hansfilipelo/Kandidadprojekt/Skrivuppgifter/Reglering/kom.tex

%Laborationsrapport

\documentclass[a4paper,12pt,fleqn]{article}
\usepackage{fixltx2e}
\usepackage[utf8]{inputenc}
\usepackage{graphicx}
\usepackage{sidecap}
\usepackage{fancyhdr}
\usepackage{amssymb,amsmath}
\usepackage[swedish]{babel}
\usepackage[margin=1.5in]{geometry}
\usepackage{abstract}
\usepackage[parfill]{parskip}
\usepackage{tocloft}
\usepackage{adjustbox}
\usepackage{textcomp}
\usepackage[T1]{fontenc}
\usepackage{listings}
\usepackage{xcolor,colortbl}
\usepackage{hyperref}

\include{pagestyle}

%-------------------------------------------------------------------
%Första sidan

\begin{document}
	\pagestyle{fancy}
\pagenumbering{roman}
	\vspace*{\fill}
		\begingroup
			\begin{center}
				\huge{\textbf{Trådlös kommunikation}}
				\\
				\vspace{10pt}
				\normalsize
				Niklas Ericson och Jens Edhammer
				\\
				Kandidatprojekt Y - Grupp 8 - VT2014
				\\
				Version 1.0
				\end{center}
		\endgroup
	\vspace*{\fill}
	
	\begin{center} %Börjar centrering 
		Status
		\\
		\vspace{3pt} %Whitespace 3 pts
	    \begin{tabular}{| p{3cm} | p{3cm} | p{3cm} |} %tabell, 4 horizontella |, 3 cm emellan dem.
	    \hline %översta horizontella linjen.
	    Granskad & - & \today \\ \hline % & -tecken för att "gå till nästa ruta" 
		Godkänd & - & - \\ \hline % avslutas med \\ och \hline.

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

				\end{center}
		\endgroup
	\vspace*{\fill}
\newpage

%-----------------------------------------------------------------
%Innehållsföreteckning

\addto\captionsswedish{\renewcommand{\contentsname}{Innehållsförteckning}}

\tableofcontents
\thispagestyle{fancy}
\newpage

\pagenumbering{arabic}
%-----------------------------------------------------------------
%Översikt
\section{Inledning}

Disposition: 
\\
1. Inledning 
\\
2. Problemformulering (frågeställningar som rapporten ska behandla) 
\\
3. Kunskapsbas (litteratur, datablad, dokumentation, etc.) 
\\
4. Fördjupningstext (modeller, beräkningar, analyser och eventuella experiment) 
\\
5. Resultat och slutsatser 

% ----------------------------- Appendix -----------------------------------------

\newpage
\appendix
\pagestyle{empty}
\newgeometry{left=2cm,right=2cm,bottom=2cm,top=2cm}
\section{Appendix A}

\end{document}
