hansfilipelo/Kandidadprojekt/Jensanteckningar.rtf

Modulär hårdvara

Samtliga kort är lätta att ta bort. Kräver inte ens verktyg.
En bandkabel mellan korten kopplar samman.
Bandkabel mellan vagn och styrmodulen.
Alla sensorer sitter på stiftlister eller i socklar.
Sensorerna är så länge samma model, plug and play.
Detsamma gäller för Bluetoothen. Ett standard konfigurerat
Firefly Bluesmirf modem kommer att fungera out of the box.
Bara att koppla in, i den färdiga sockeln på kommunikationskortet.

Nu vill vi prata lite mer om de individuella modulerna.

1:20

Kommunikationsmodul
Sköter kommunikationen och är navet i roboten.
SPI-Buss.
Vår SPI buss utnyttjar en dubbelbuffer (mottagning, datahantering).
Hantering sker utanför avbrotten med hjälp av bool på master.
Nytt avbrott genereras på slaves när data ska hanteras.
Vi har avbrott uppåt från dottermodulerna.
Vi har ett eget protokoll som börjar med att ge en längd. Väldigt modulärt protokoll.

Bluetooth
Bluetooth använder samma protokoll men har fix längd på 27 (max längd över SPI).
Detta förenklar mottagningsfunktionerna på PC och AVR sidan.

LCD-display
Buffersystem, läser readyflagga en gång per main-loop, uppdaterar position alt. tecken.

Lärdomar
Vi har lärt oss väldigt mycket.
Saker vi vill göra annorlunda eller arbeta vidare med i nästa projekt.

Svårt att implementera buss.
Många skulle nog hålla med oss.
Utnyttja en länkad lista på alla processorer en för skickning en för mottagning.
Gå ut och med jämna mellanrum och fråga modulerna efter data istället
(skulle försämra våra svängar pga ’latens’.)
Ändra strukturen och uppgifterna hos modulerna för att minimera (kritisk) kommunikation.
Paritet eller Ack-struktur.

Starkare huvudprocessor för klasstruktur och beslut med dotterprocessorer för utförande.
En stark ARM huvudprocessor för tillgång till fulla standardbiblioteket i C++.
Låt Huvudprocessorn göra alla beslut och be dottermodulerna utföra dessa istället.

Oscilloskopets styrka i felsökning.
