hansfilipelo/Kandidadprojekt/Presentation/Presentation.pdf

# MapMaster2001

Den kartritande roboten

Nikki

Nikki 2 min

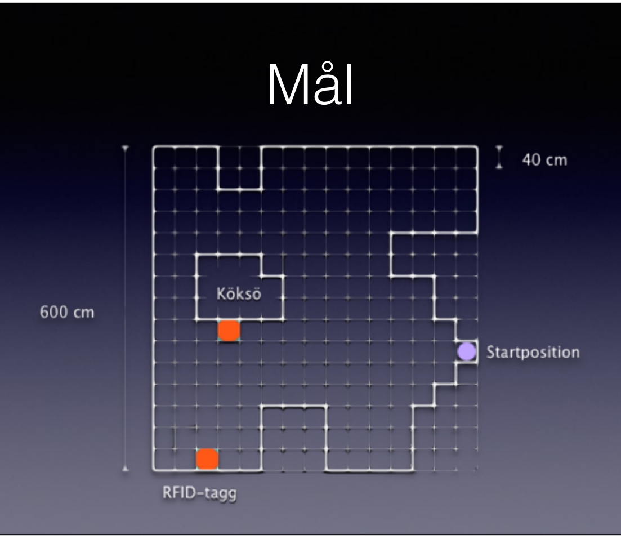
[picture p44: figure]
Mål

Nikki - 30-45 sekunder

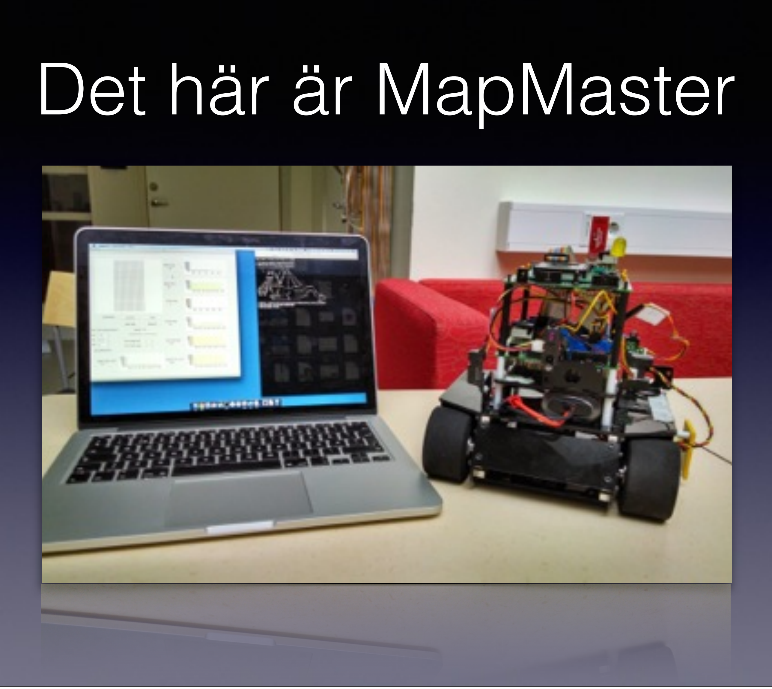
[picture p45: figure]
Det här är MapMaster

# Funktion

- Avsöker och kartlägger ett område
- Ritar karta i ett modernt användargränssnitt
- Bygger på en objektorienterad design
- Spara data och granska den i efterhand

Nikki - 2 min

# Användargränssnitt

Tobias - 1 min

Tobias - 2 min

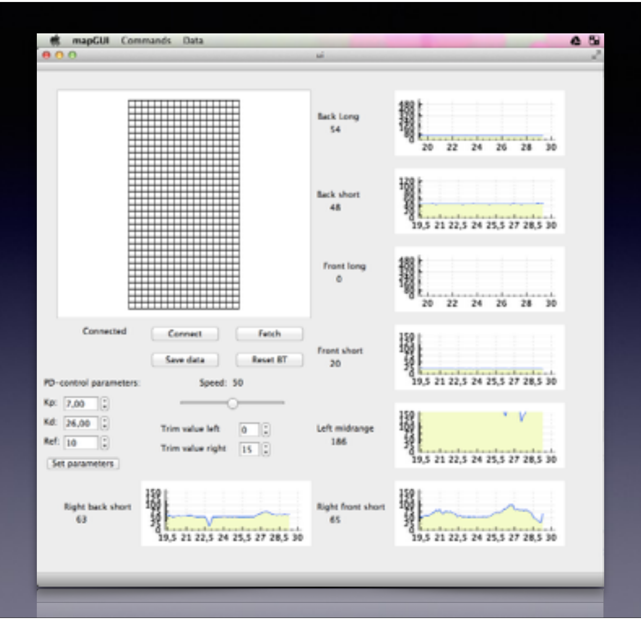
[picture p46: figure]

# Kartabstraktion

H-F - 2 min

# Objektorienterad karta

- Kan fråga kartobjekt
- Mer intelligens med mindre arbete

H-F

# Canceralgoritmen

H-F - 2 min

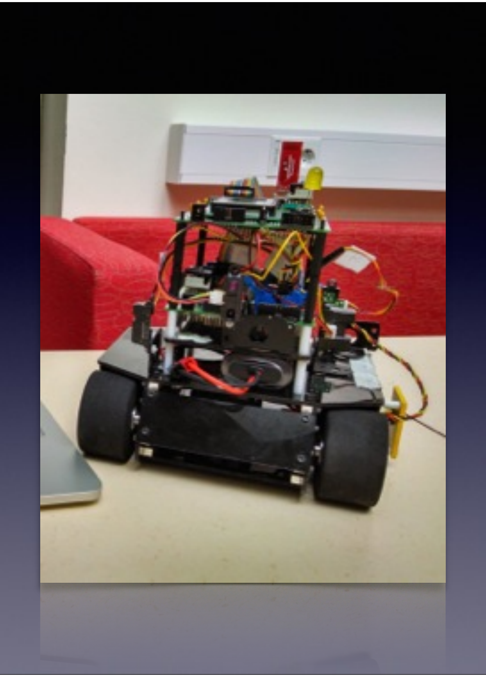
[picture p47: figure]

## Modulär hårdvara

Jens - 1,5 min

# Kommunikationsmodul

- SPI-buss
- Bluetooth
- LCD-display

Jens - 4 min

# Sensormodul

- Lågpassfiltrering av sensorer
- Medelvärdesbildning av sensordata
- Självkalibrerande gyro

David - 3 min

# Styrmodul

- Dubbel proportionell reglering med deriverande effekt.
- Kartläggningsalgoritm med detektering av köksöar.

Erik - 5 min

Erik

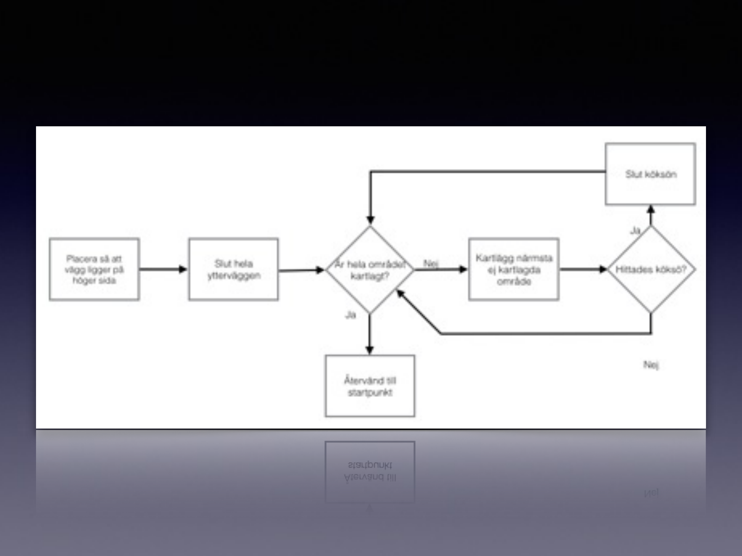
[picture p48: figure]

# Lärdomar

- Det är svårt att implementera buss
- Starkare huvudprocessor för klasstruktur och beslut, med dotterprocessorer för utförande.
- Oscilloskopets styrka i felsökning

Jens - 4 min

Frågor?
