hansfilipelo/Kandidadprojekt/Mötesprotokoll/2014_04_03.md

Protokoll möte 3/4 2014
=========

- Bussprotokoll
 	
	Alla processorer har två globala arrayer a 25 chars. En för inkommande data och en för utgående data. Arrays fylls på enligt: 
 	- Längd (allt efter längd) | Kodord | Arg | Data
 	
 	Ska anropas enligt: 
 		outataArray = arrayToSend;
		SPISendArray();

===

- Sensordata, hur ofta och hur?
	Erik och David ska mäta hur lång tid det tar och återkomma.
