hansfilipelo/Kandidadprojekt/Skrivuppgifter/Reglering/regler.tex

\documentclass[a4paper,12pt,fleqn]{article}
\usepackage{fixltx2e}
\usepackage[utf8]{inputenc}
\usepackage{graphicx}
\usepackage{sidecap}
\usepackage{fancyhdr}
\usepackage{amssymb,mathtools}
\usepackage[swedish]{babel}
\usepackage[margin=1.5in]{geometry}
\usepackage{abstract}
\usepackage[parfill]{parskip}
\usepackage{tocloft}
\usepackage{adjustbox}
\usepackage{textcomp}
\usepackage[T1]{fontenc}
\usepackage{listings}
\usepackage{xcolor,colortbl}
\PassOptionsToPackage{hyphens}{url}\usepackage{hyperref}

\include{pagestyle}

%-------------------------------------------------------------------
%Första sidan

\begin{document}
	\pagestyle{empty}
	 \pagenumbering{gobble}
	\vspace*{\fill}
		\begingroup
			\begin{center}
				\huge{\textbf{Simultan positionering och kartläggning}}
				\\
				\vspace{10pt}
				\normalsize
				Tobias Grundström och Hans-Filip Elo
				\\
				Kandidatprojekt Y - Grupp 8 - VT2014
				\\
				Version 1.0
				\end{center}
		\endgroup
	\vspace*{\fill}

	\begin{center} %Börjar centrering 
		Status
		\\
		\vspace{3pt} %Whitespace 3 pts
	    \begin{tabular}{| p{3cm} | p{3cm} | p{3cm} |} %tabell, 4 horizontella |, 3 cm emellan dem.
	    \hline %översta horizontella linjen.
	    Granskad & TG \& HFE & \today \\ \hline % & -tecken för att "gå till nästa ruta" 
		Godkänd & - & - \\ \hline % avslutas med \\ och \hline.

	    \end{tabular}
	\end{center}
	\vspace{2cm}
	\newpage
%-----------------------------------------------------------------
%Projektidentitet

	\vspace*{\fill}
		\begingroup
			\begin{center}
				\pagenumbering{roman}
				\LARGE{\textbf{PROJEKTIDENTITET}}
				\\
				\footnotesize
				Grupp 8, 2014/VT, MapMaster2001
				\\
				Linköpings tekniska högskola, Institutionen för Systemteknik (ISY)
				\\
				\vspace{1cm}
	  \begin{tabular}{| p{3cm} | p{4.3cm} | p{2.4cm} | p{3.8cm} |}
	    \hline
		\textbf{Namn} & \textbf{Ansvar} & \textbf{Telefon} & \textbf{E-post} \\ \hline
	    Jens Edhammer & Dokumentanvsvarig (DOK) & 076-030 67 80 & jened502@student.liu.se \\ \hline
		Erik Ekelund & Designansvarig (DES) & 073-682 43 06 & eriek984@student.liu.se \\ \hline
		David Habrman &  & 976-017 71 15 & davha227@student.liu.se \\ \hline 
		Tobias Grundström & Testansvarig (TES) & 073-830 44 45 & tobgr602@student.liu.se \\ \hline 
		Hans-Filip Elo &   & 073-385 22 32 & hanel742@student.liu.se \\ \hline 
		Niklas Ericson & Projektledare (PL) & 073-052 27 05 & niker917@student.liu.se \\ \hline
	    \end{tabular}

		\vspace{1cm}
		\textbf{E-postlista för hela gruppen:} mapmaster2001@cyd.liu.se
		\\[0.5cm]

		\textbf{Kund}: Mattias Krysander, Linköpings universitet, 581 83  LINKÖPING, \\
		013-28 21 98, matkr@isy.liu.se \\
		\textbf{Kontaktperson hos kund}: Mattias Krysander, 013-28 21 98,matkr@isy.liu.se 
		\\
		\textbf{Kursansvarig}: Tomas Svensson, 3B:528,013 28 21 59,tomass@isy.liu.se
		\\[0.5cm]
		\textbf{Handledare}: Peter Johansson, 013-28 1345 peter.a.johansson@liu.se

				\end{center}
		\endgroup
	\vspace*{\fill}
\newpage

%-----------------------------------------------------------------
%Innehållsföreteckning

\addto\captionsswedish{\renewcommand{\contentsname}{Innehållsförteckning}}

\tableofcontents
\newpage
\pagestyle{fancy}
\pagenumbering{arabic}
%-----------------------------------------------------------------
%Översikt

%------------------------------------------------
%--------------------Inledning-------------------
%------------------------------------------------
\section{Inledning}

Simultan positionering och kartläggning (SLAM) är ett problem som grundar sig i följande frågeställning: Utan att veta var vi är - hur kartlägger vi då vår omgivning? Åt andra hållet får man ställa sig frågan - hur vet vi var vi befinner oss utan en karta?

Det är inte helt enkelt att lösa dessa frågor, men det finns approximativa lösningar på SLAM-problemet. Gemensamt för alla lösningar är att de bygger på möjligheten att läsa av sin omgivning i kombination med
sannolikhetsteori. Då sensordata aldrig kan antas vara exakt använder man sannolikhetsteori för att göra rimlighetsbedömningar i de stickprov av mätningar sensorerna ger.

SLAM-problemet är alltså oftast inte entydigt lösbart rent matematiskt, utan
bygger på sannolikhetsteori i kombination med att moderna processorer
och minnen kan hantera en stor mängd data. Moderna processorer möjliggör
alltså ett stort stickprov vilket kan leda till en mindre osäkerhet.

\subsection{Syfte}
Syftet med denna rapport är att ge läsaren en introduktion till de algoritmer och tekniker som används för kartläggning och positionsbestämning i ett mikroprocessorsystem.

\subsection{Historia}

Principerna för SLAM formulerades för första gången 1986\footnote{Smith, R.C.; Cheeseman, P. (1986).
''On the Representation and Estimation of Spatial Uncertainty''. The
International Journal of Robotics Research, 5(4), sida 56–68.}. Redan vid formuleringen av problemet beskrevs SLAM som en inexakt vetenskap. SLAM handlar om att skaffa sig en approximativ uppfattning av sin omgivning och position som är tillräckligt bra för att fatta ett beslut kring färdväg och/eller kartläggning. 

Utvecklingen på området har sedan dess accelererat kraftigt tack vare
mikrokontrollers förmåga att hantera mer data vilket är intressant eftersom noggrannheten i SLAM gynnas kraftigt av att arbeta med stora stickprov. 

För den som vill läsa på mer om SLAM går det att finna litteratur och artiklar som berör ämnet. Om läsaren vill få en mer övergripande bild utan att gå in så mycket på beräkningar erbjuder den vetenskapliga artikeln ''SLAM for dummies''\footnote{Risgaard, S; Blas, M.R (2005).
''SLAM for Dummies, A Tutorial Approach to Simultaneous Localization and Mapping''. 
Hämtad 28 mars 2014:
\url{http://ocw.mit.edu/courses/aeronautics-and-astronautics/16-412j-cognitive-robotics-spring-2005/projects/1aslam_blas_repo.pdf}
} en bra förklaring. Ytterligare läsning finns i David Törnqvists doktorsavhandling ''Estimation and Detection with Applications to Navigation''. Där beskriver Törnqvist teorin bakom SLAM på ett pedagogiskt och detaljerat sätt. \footnote{Törnqvist, D. (2008). Estimation and Detection with Applications to Navigation. PhD thesis, Linköping University. \url{http://urn.kb.se/resolve?urn=urn:nbn:se:liu:diva-14956}.}
 
På senare år har man även, precis som inom många andra vetenskapliga områden, sett utvecklingen ta ytterligare ett kliv tack vare internet och öppna källkodsprojekt som Github och OpenSLAM. Att göra en sökning på SLAM på Github resulterar i en mängd aktiva projekt på området. Eftersom källkoden där också finns tillgänglig är detta ett utmärkt exempel för de som vill studera implementeringar av SLAM-algoritmer. 

%------------------------------------------------
%-------------Problemformulering-----------------
%------------------------------------------------

\section{Problemformulering}

Vanligtvis där SLAM implementeras ska en robot försöka kartlägga sin omgivning och utföra en uppgift. Antag att en robot med fyra hjul och tillgång till ett antal avståndssensorer och ett gyro placeras i ett okänt slutet område. Den ska, med en vägg som startpunkt, helt autonomt kartlägga området genom att markera ut var väggar finns och var det finns områden som inte går att nå. Om inte hela det slutna området är kartlagt ska den upptäcka vilka segment som är oupptäckta, färdas dit och lägga till det slutna området i kartan. När området är kartlagt ska roboten ta sig tillbaka till startpunkten för att kunna återhämtas och på så sätt avsluta arbetet. Marken under roboten antas vara slät med förhållandevis stor friktion mot robotens däck. 

SLAM är en teknik där ett system på något sätt kan uppfatta landmärken. Med landmärken menas alla typer av objekt eller liknande som kan användas som referenser. Landmärkenas position i förhållande till roboten ska noteras och uppmätas med regelbundna samplingar. Genom att positionsbestämma dessa landmärken kan roboten snabbare bestämma sin position. 

SLAM-problemet definieras av robotens position och orientering i förhållande till utgångspunkten vid tidpunkten t, även kallat $x_{t}^r$, landmärkenas positioner $m_t$, styrsignaler $u_{t}$ och mätningar med sensorer $y_{t}$. Målet är att skatta robotens position vid aktuell tidpunkt utifrån föregående position och de givna styrsignalerna. Detta ska göras trots eventuella systemstörningar ($v$) och mätstörninger ($e$). Landmärken antas ha statiska positioner. 

I många fall kan man beskriva SLAM-problemet med tillståndsmodellen

\begin{gather}
x_{t}^r = f(x_{t-1}^r, u_{t-1}, v_{t-1}) \\
m_{t} = m_{t-1} \\
y_{t}^i = h(x_{t}^r,m_{t}^i) + e_{t}^i
\end{gather}

% Gneta ihop det lite här /H-F
%
Vad är det då för typ av mätningar som kan göras? För att kunna utföra SLAM krävs det att man gör någon form av odometri, det vill säga att man kontinuerligt uppskattar vägen som färdats relativt sin senaste position. Odometri kan göras på olika sätt - exempelvis genom att mäta relativa avstånd utifrån bilder av omgivningen, vinkelhastigheter hos hjul med känd storlek eller steg med given längd. 

Utöver relativa mätningar över kortare tidsintervall används också absoluta mätningar av omgivningen för att korrigera de fel som de relativa mätningarna orsakar över tiden. Många robotar nyttjar förmågan att optiskt mäta objekt i sin omgivning, men det förekommer även implementeringar med radar, sonar eller GPS. 

Med absoluta mätningar till omvärlden finns alltid möjligheten att korrigera tidigare felaktiga mätvärden genom att samla in mer mätdata för att på ett korrektare sätt kunna beskriva sin omgivning. Av den anledningen är all typ av SLAM beroende av att på något sätt granska sin omgivning. 

\subsection{Mätningar}

För att kunna avgöra var roboten befinner sig behövs ett eller flera sätt för att känna sin omgivning och sitt tillstånd. Roboten kan till exempel behöva utföra mätningar av avstånd, hastighet och vinkelhastighet för att åstadkomma detta. 

\subsubsection{Avståndssensor}

Som avståndsmätare kan någon typ av optisk sensor användas. Att sensorn är optisk innebär att den använder sig av ljus för att utföra mätningarna. De finns till exempel sensorer som belyser en yta som avståndet ska mätas till, tar emot reflekterat ljus och sedan med hjälp av tiden det tagit för ljuset att färdas beräknar avståndet. Denna metod kallas time-of-flight. Ytterligare en metod som används kallas optisk triangulering och det innebär att med hjälp av vinkeln mellan sändare och mottagare bestämma avståndet till objektet.
\newpage

\subsubsection{Gyroskop och accelerometer}

Gyroskop och accelerometrar kan användas i samverkan för att bestämma relativ rörelse. Ett gyroskop kan känna av ett objekts vinkelhastighet kring tre axlar. En accelerometer kan i sin tur känna av ett objekts förändring i hastighet i alla tre dimensioner. Förutsatt att den initiala hastigheten är känd kan en accelerometer användas för att beräkna färdad sträcka genom två-stegs tidsintegration. 

Gyroskop och accelerometrar använder sig av liknande underliggande tekniker. Antingen består de av en eller flera massor i ledande material som i kombination med ett hålrum skapar en accelerationsberoende kapacitans\footnote{Weinberg, H.(1999), ''Dual Axis, Low g, Fully Integrated Accelerometers''. Hämtad 12 maj 2014: \url{http://www.analog.com/library/analogdialogue/archives/33-01/accel/index.html}.}. En annan teknik är att använda piezoelektriska material för att generera en förändring i kapacitans då en kraft verkar på en massa.\footnote{Choudhary, V. Iniewski, K. (2013). MEMS - Fundamental Technology and Applications. CRC Press. ISBN: 978-1-4665-1582-6.} 

För en accelerometer används en massa som hålls fast av en arm med en viss elasticitet. Massan omges av strömförande ledare och skapar tillsammans med dem en kapacitans. Då accelerometern rör sig förändras kapacitansen - vilket är mätbart. Principen illustreras väldigt enkelt i figur \ref{fig:accelerometer}.

\begin{figure}[htp] %Placera här om det finns plats, annars så snart som möjligt, på toppen av en sida.
  \begin{center}
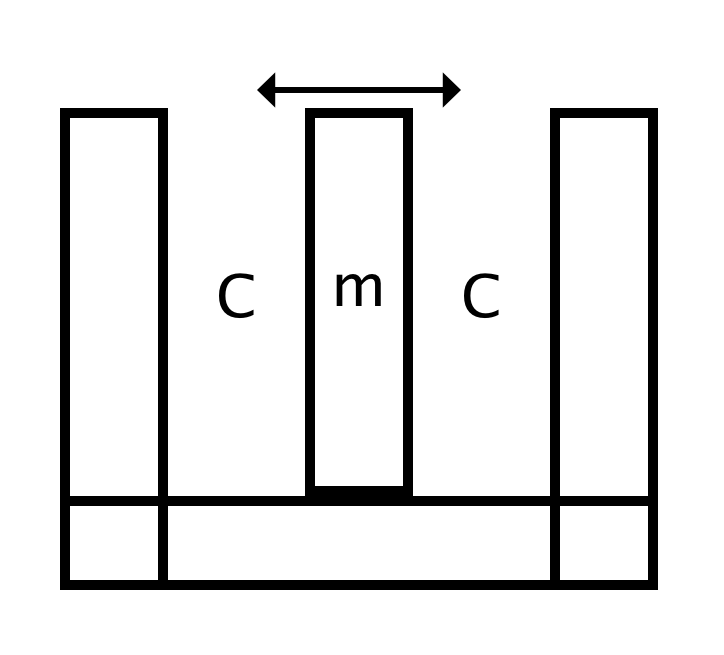
[picture p49: Skrivuppgifter/Reglering/accelerometer.png]
    %skala och filnamn. 
  \end{center}
  \caption{Modell av accelerometer} %figurtext.
  \label{fig:accelerometer}
\end{figure}

En gyrosensor av MEMS-typ (Micro Electro-Mechanical System) utnyttjar att två lika stora massor som oscillerar konstant i motsatta riktningar påverkas av corioliskraften vid rotation. Kraften verkar i olika riktningar på de två massorna vilket leder till en förändring i kapacitans.
Skillnaden i kapacitans har visat sig vara proportionell mot vinkelhastigheten, och därför går det att bestämma vinkelhastigheten med hjälp av ett gyro av denna typ \footnote{Introduction to MEMS gyroscopes. Solid State Technology, Insights for Electronics  Manufacturing. Hämtad 6 maj 2014: \url{http://electroiq.com/blog/2010/11/introduction-to-mems-gyroscopes/}}. 

\subsubsection{Hjulsensorer}

Vid vissa tillfällen kan det vara så att avståndssensorer ej kan användas för att skatta rörelse relativt landmärken, exempelvis om alla landmärken är utanför sensorernas räckvidd. Man kan då behöva skatta sin rörelse med hjälp av någon annan sensor. En vanlig typ av sensor är då hjulsensorer. Hjulsensorer räknar hur många varv hjulen snurrat och skattar sedan avståndet roboten färdats utifrån detta. 

Ett problem med hjulsensorer är att de inte ger en helt korrekt hastighets- och distansskattning då hjulen ofta slirar mot underlaget.

\subsubsection{Andra typer av sensorer}

I denna rapport berör vi mest fallet att SLAM baseras på optiska avståndssensorer, hjulsensorer och gyro, men det finns även andra typer av sensorer som går att använda. Till exempel finns det implementeringar som använder sig av kameror för att finna landmärken och sedan använda dessa som referenser. Det krävs dock mer avancerade algoritmer för att finna lämpliga landmärken i detta fall \footnote{Karlsson, N.; Goncalves, L.; Munich, M.E.; Pirjanian, P. (2005). ''The vSLAM Algorithm for Navigation in Natural Environments''. Evolution Robotics, Inc.}.

Något som också provats är SLAM utan användning av någon typ av optisk utrustning där man istället förlitar sig på känsel. Med hjälp av känselsensorer, som efterliknar djurs morrhår, försöker man då kartlägga ett helt mörklagt rum. Denna metod har dock inte gett så bra resultat med de tekniker som existerar i dag\footnote{Fox, C.; Evans, M.; Pearson, M.; Prescott, T. (2012)
''Tactile SLAM with a biomimetic whiskered robot''. 2012 IEEE International Conference on Robotics and Automation. Hämtad 28 mars 2014:
\url{http://ieeexplore.ieee.org/stamp/stamp.jsp?tp=&arnumber=6224813}
}. 

\subsubsection{Absolut positionsskattning}Tidigare nämndes exempel på metoder som använder sig av GPS. Detta i kombination med WiFi-signaler har använts till exempel i mobiltelefoner för att ge en positionsskattning med absolut referens för var enheten befinner sig. För att WiFi-SLAM ska fungera krävs att accesspunkten har information om positionsdata för sig själv, alternativt att den anslutna enheten har information om var aktuellt WiFi är tillgängligt.

I tillämpningar där positionen inte behöver skattas med så hög noggrannhet är GPS fullt tillräcklig och SLAM-algoritmer behöver därför inte implementeras. Om man däremot behöver mer noggrannhet och robusthet än vad GPS kan ge kan GPS användas som ett hjälpmedel för att snabbt uppskatta inom vilket område man befinner sig för att kraftigt förenkla SLAM-problemet. 

%------------------------------------------------
%--------------------Fördjupning-----------------
%------------------------------------------------
\newpage
\section{Skattningsmetoder för SLAM-problemet}
I denna fördjupande del går vi igenom metoder som kan användas för att utföra SLAM i en miljö lik den i problemställningen. Bland annat kommer tillståndsrepresentation och skattning av tillstånd med hjälp av observatörer samt kalmanfilter att tas upp.

%----------------------Tillståndsrepresentation av reglersystem------------------

\subsection{Tillståndsrepresentation av reglersystem}

Inom reglerteknik kan linjära system beskrivas på så kallad tillståndsform\footnote{Glad, T; Ljung, L. (2006), \textit{Reglerteknik - Grundläggande teori}.}. I fallet med SLAM för en robot använder man robotens position och orientering som tillstånd, som beskrivits tidigare. Ett tidskontinuerligt linjärt system kan skrivas på tillståndsform enligt
\begin{gather}
\dot{x}=Ax+Bu \\
y=Cx+Du	
\label{equ:tillstand}
\end{gather}
där $A$, $B$, $C$ och $D$ är matriser.

Tillstånden för en robot mäts vid diskreta tidpunkter då datorer vanligen endast hanterar tidsdiskreta mätningar och ej kontinuerliga. I dessa fall är det bättre att använda sig av en tidsdiskret tillståndsbeskrivning
\begin{gather}
x_{n+1} = Ax_n + Bu_n \\
y_n = Cx_n + Du_n
\label{equ:disktillstand}
\end{gather}

Om systemet istället skulle vara icke-linjärt så går det inte att beskriva det på samma sätt utan man får använda sig av en olinjär tillståndsbeskrivning
\begin{gather}
	x_{t+1}=f(x_t,u_t)\\
	y_t=h(x_t,u_t)
\end{gather}

Man kan få en approximativ linjäriserad beskrivning av ett sådant system genom att använda sig av taylorutveckling, vilket i slutändan leder till att $A$-, $B$-, $C$- och $D$-matriserna innehåller partiella derivator. Dessa matriser kallas jacobianer, $J$ och skrivs
\begin{gather}
	J= \begin{pmatrix}
	\frac{\partial f_1}{\partial x_1} & \dots & \frac{\partial f_1}{\partial x_n} \\
	  							\vdots &       & \vdots \\
	  \frac{\partial f_n}{\partial x_1} & \dots & \frac{\partial f_n}{\partial x_n}
	  \end{pmatrix}
	  \label{equ:jacobian}
\end{gather}

I ett praktiskt implementerbart system nyttjas till exempel sensorer som ger mätsignaler med en viss osäkerhet på mätdatan för att bestämma systemets tillstånd. Man kan därmed enbart skatta systemets tillstånd och inte exakt beräkna det. För att skatta tillståndet används ofta en så kallad observatör.

\subsubsection{Observatörer}

Inom reglerteknik används en observatör för att skatta tillståndsvariabler i ett givet system. Tillståndet för systemet (4)-(5) kan skattas med hjälp av observatören

\begin{gather}
\dot{\hat{x}} = Ax + Bu + K(y - C\hat{x})
\label{equ:observer}
\end{gather}

Skattningsfelet $\tilde{x}= x - \hat{x}$ ges då av differentialekvationen

\begin{gather}
\dot{\tilde{x}} = (A - KC)\tilde{x}
\label{equ:observerError}
\end{gather}

Genom att sedan välja olika $K$-matriser får observatören olika egenskaper i form av konvergenshastighet och störningskänslighet. 

\subsubsection{Tidskontinuerligt och tidsinvariant kalmanfilter}

Antag att systemet (4)-(5) påverkas av mätstörningen $e$ och systemstörningen $v$ som specificerades i problemformuleringen
\begin{gather}
\dot{x}=Ax+Bu+v \\
y=Cx+Du+e
\end{gather}

Skattningsfelet ges då istället av: 
\begin{gather}
\dot{\tilde{x}} = (A - KC)\tilde{x} + v - Ke
\end{gather}

Då $v$ och $e$ antas vara vita brus kan man, genom att utgå från störningarnas kovariansmatriser $R_1$ och $R_2$, beräkna skattningsfelets kovarians. Kovariansen hos skattningsfelet minimeras sedan genom att välja 
\begin{gather}
K = PC^{T}R_{2}^{-1}
\end{gather}

där matrisen $P$ är den positivt semidefinita lösningen till 
\begin{gather}
AP + PA^{T} + R_{1} - PC^{T}R_{2}^{-1}CP = 0
\end{gather}

I många praktiska tillämpningar antas $R_{1}$ och $R_{2}$ vara diagonalmatriser för att förenkla implementeringar. Dessa matriser väljs sedan beroende på hur mycket systemet påverkas av yttre störningar av olika typ. 

\subsubsection{Tidsdiskret och tidsvariabelt kalmanfilter} Inom SLAM är både hastighet och störningskänslighet essentiellt och man använder därför en tidsvariabel $K$-matris. Det vanliga kalmanfiltret är tyvärr inte effektivt vid SLAM, eftersom filtret enbart kan användas för linjära system. För att skatta nästkommande tillstånd med variabel $K$-matris används därför vanligen ett utökat kalmanfilter vid implementeringar av SLAM. 

För att beskriva det utökade kalmanfiltret behöver vi först beskriva det tidsdiskreta och tidsvarianta kalmanfiltret. Systemet beskrivs då som 
\begin{gather}
x_{n+1} = A_nx_n + B_nu_n+v_n \\
y_n = C_nx_n + D_nu_n + e_n
\end{gather}
och skattningen ges av
\begin{gather}
	\hat{x}_{n|n-1} = A_{n-1}\hat{x}_{n-1|n-1} + B_{n-1}u_{n-1} \\
	P_{n|n-1}=A_{n-1}P_{n-1|n-1}A^T_{n-1}+R_1 \\
	K_n = P_{n|n-1}C_{n}^T(C_{n}P_{n|n-1}C_{n}^T+R_2)^{-1}	\\
	\hat{x}_{n|n} = \hat{x}_{n|n-1} + K_{n}(y_{n}-C_{n|n-1}\hat{x_{n|n-1}})\\
	P_{n|n}=(I-K_nC_n)P_{n|n-1}	
\end{gather}

där $R_1$ och $R_2$ är kovariansmatriserna för $v_n$ respektive $e_n$. $A_n$-,$B_n$-,$C_n$- och $D_n$-matriserna varierar med tiden.\footnote{Gustafsson, F; Ljung, L; Millnert, M. (2000). \textit{Signalbehandling}. Andra upplagan. Lund. Studentlitteratur.}

\subsubsection{EKF - Det utökade kalmanfiltret}

Till skillnad från kalmanfiltret kan det utökade kalmanfiltret (EKF) användas för att approximativt lösa icke-linjära SLAM-problem. Det som möjliggör detta är att filtrets matriser beräknas om för varje ny tillståndsskattning. Matriserna för filtret beräknas med hjälp av jacobianer, och systemet linjäriseras därmed kring varje skattat tillstånd för att kunna skatta nästa tillstånd. Antag att tillståndsrepresentationen av ett icke-linjärt system kan skrivas

\begin{gather}
	x_{t} = f(x_{t-1}, u_{t-1}) + v_{t-1} \\
	y_{t} = h(x_{t},u_{t}) + e_{t}
\end{gather}

Det utökade kalmanfiltret baseras då på en linjärisering av systemet och ger en prediktion av dess tillstånd, enligt:

\begin{gather}
	\hat{x}_{t|t-1} = f(\hat{x}_{t-1|t-1}, u_{t-1})
\end{gather}

Matriserna $K_t$ och $P_{t|t-1}$ i filtret, samt skattningen $\hat{x_{t|t}}$ ges sedan av

\begin{gather}
	P_{t|t-1} = F_{t-1}P_{t-1|t-1}F^T_{t-1}+R_{1},\;\;\;\;\;\; med \; F_{t-1} = \frac{\delta f(x,u)}{\delta x}\big|_{(x,u) = (\hat{x}_{t-1|t-1}, u_{t-1})} \\
	K_{t} = P_{t|t-1}H_{t}^T(H_{t}P_{t|t-1}H_{t}^T+R_{2})^{-1}\;\;\;\;\;\; med \; H_{t} = \frac{\delta h(x,u)}{\delta x}\big|_{(x,u) = (\hat{x}_{t|t-1}, u_{t})} \\
	\hat{x}_{t|t} = \hat{x}_{t|t-1}+K_{t}(y_{t}-h(\hat{x}_{t|t-1},u_{t}))
\end{gather}

$P$ uppdateras sedan inför nästa tillstånd med

\begin{gather}
	P_{t|t} = (I-K_{t}H_{t})P_{t|t-1}
\end{gather}

Matriserna $H_t$ och $F_t$ är alltså jacobianer för systemfunktionerna och dessa linjäriseras därmed i varje punkt.\footnote{Törnqvist, D. Estimation and Detection with Applications to Navigation, s 31.}

I det fall då EKF används för SLAM består tillståndsvektorn som skattas av både robotens tillstånd $x^r_t$ och landmärkens positioner $m_t$ enligt (1)-(2).

\newpage

\subsection{FastSLAM}
FastSLAM är en relativt modern teknik som använder ett så kallat partikelfilter för att filtrera mätdata, där varje tänkbart tillstånd för systemet ses som en partikel. De mest sannolika värdena sparas och de minst sannolika tillstånden förkastas. Man kallar det här för en omsampling då man utgår från en sampelmängd av tillstånd och sedan uppdaterar denna när man får nya mätningar\footnote{Törnqvist, D. Estimation and Detection with Applications to Navigation.}. Antag att partikelfiltret plockar ut $N$ tillstånd ur den totala mängden tillstånd så att 

\begin{gather}
x^i_n,m^i_n \sim p(x_n,m_n|y_{1:n}),\;\;\;\;\;\; i = 1, ..., N
\end{gather}

där, som tidigare nämnts, $x_n$ är robotens tillstånd, $m_n$ är landmärkenas positioner och $y_{1:n}$ är mätningarna.  

Kortfattat bygger principen bakom FastSLAM på att sannolikhetsfördelningen för landmärkenas positioner och robotens tillstånd delas upp, där robotens position skattas med hjälp av ett partikelfilter och landmärkena skattas med EKF. Nackdelen med metoden är att man genom omsampling av mätvärdena förlorar information som skulle kunna vara korrekt. Beroende på hur filtret prioriterar är det möjligt att man får en skev bild av omgivningen. 

För att effektivisera filtreringen av mätvärden delas olika distinkt upptäckta objekt i robotens miljö in i olika zoner. Dessa zoner filtreras sedan individuellt för att få fram den mest sannolika positionen för objektet i zonen.

%------------------------------------------------
%------------Resultat och slutsatser-------------
%------------------------------------------------
\newpage
\section{Slutsats}

Frågan som SLAM grundas på går nu att delvis besvara. Det går att kartlägga en omgivning utan att exakt veta sin position, men det behövs någon typ av skattning av positionen för att göra en rimlig kartläggning. Ju bättre skattningen är desto bättre kommer kartan att bli i slutändan. Mer data och data av högre kvalitet kan bidra till att förbättra noggrannheten på skattningarna. FastSLAM verkar vara en metod som ger en bra skattning av tillstånden med relativt lite beräkningar. Den slutsatsen är dock bara baserad på den teori som vi tagit upp i rapporten, eftersom inga tester genomförts i praktiken. En nackdel med FastSLAM är att det är två relativt teorikrävande komponenter som måste förstås för att man ska kunna implementera det, partikelfilter och EKF.

Ett problem som kan uppstå då fler typer av sensorer används och större mängder data måste bearbetas är att beräkningskraften inte räcker till då filtren och mjukvaran som används för att implementera SLAM kan ställa för höga krav på beräkningsenheten. 

\section{Reflektion}

Sett från det perspektiv vi granskar SLAM-problemet, inom ett kandidatprojekt, är avancerade SLAM-algoritmer för komplicerade för att implementera. Det kan dock vara fördelaktigt att använda någon typ av filter i en SLAM-implementering. Då beräkningar man gjort tidigare under kartläggningen till exempel ger konflikt med nuvarande mätning om huruvida en vägg faktiskt finns där eller ej. Enklare fall av filtrering kommer alltså att behöva lösas vid vår framtida implementering. 

Slutligen kan man säga att denna fördjupning inom SLAM givit oss bra förutsättningar att skapa en implementerbar metod för hur vår robot ska kartlägga sitt slutna område. 

% --------------- Källförteckning ---------------------
\newpage 
\section*{Källförteckning} 
\addcontentsline{toc}{section}{Källförteckning}

Choudhary, V; Iniewski K. (2013). MEMS-Fundamental Technology and Applications. CRC Press.
eBook ISBN: 978-1-4665-1582-6.

Fox, C.; Evans, M.; Pearson, M.; Prescott, T. (2012)
''Tactile SLAM with a biomimetic whiskered robot''. 2012 IEEE International Conference on Robotics and Automation, sid 4925-4930 Hämtad 28 mars 2014.\\
\url{http://ieeexplore.ieee.org/stamp/stamp.jsp?tp=&arnumber=6224813}

Glad, T; Ljung, L. (2006). \textit{Reglerteknik - Grundläggande teori}. Upplaga 4:10. Lund. Studentlitteratur.

Gustafsson, F; Ljung, L; Millnert, M. (2000). \textit{Signalbehandling}. Andra upplagan. Lund. Studentlitteratur.

Karlsson, N.; Goncalves, L.; Munich, M.E.; Pirjanian, P. (2005)
''The vSLAM Algorithm for Navigation in Natural Environments''. Korean Robotics Society Review, vol 2 nr. 1, sid 51-67. Hämtad 28 mars 2014:\\
\url{http://www.vision.caltech.edu/mariomu/research/papers/vSLAM-krs.pdf}

Risgaard, S; Blas, M.R (2005).
''SLAM for Dummies, A Tutorial Approach to Simultaneous Localization and Mapping''. 
Hämtad 28 mars 2014:\\
\url{http://ocw.mit.edu/courses/aeronautics-and-astronautics/16-412j-cognitive-robotics-spring-2005/projects/1aslam_blas_repo.pdf}

Smith, R.C.; Cheeseman, P. (1986). ''On the Representation and Estimation of Spatial Uncertainty''. The
International Journal of Robotics Research, 5(4), sida 56–68. Hämtad
28 mars 2014:\\
\url{http://www.frc.ri.cmu.edu/~hpm/project.archive/reference.file/Smith&Cheeseman.pdf}

Törnqvist, D. (2008). Estimation and Detection with Applications to Navigation.  PhD thesis, Linköping University.\\ \url{http://urn.kb.se/resolve?urn=urn:nbn:se:liu:diva-14956}. 

Weinberg, H. (1999). ''Dual Axis, Low g, Fully Integrated Accelerometers''. Analog Dialogue 33-1, sid 1-2. Hämtad 12 maj 2014:\\
 \url{http://www.analog.com/library/analogdialogue/archives/33-01/accel/index.html}. 
\subsection*{Webbsidor}

Introduction to MEMS gyroscopes. Solid State Technology, Insights for Electronics  Manufacturing (\url http://electroiq.com).. Hämtad 6 maj 2014: \\
  \url{http://electroiq.com/blog/2010/11/introduction-to-mems-gyroscopes/}.
\end{document}
