hansfilipelo/Kandidadprojekt/Designspec/komschema.jpg

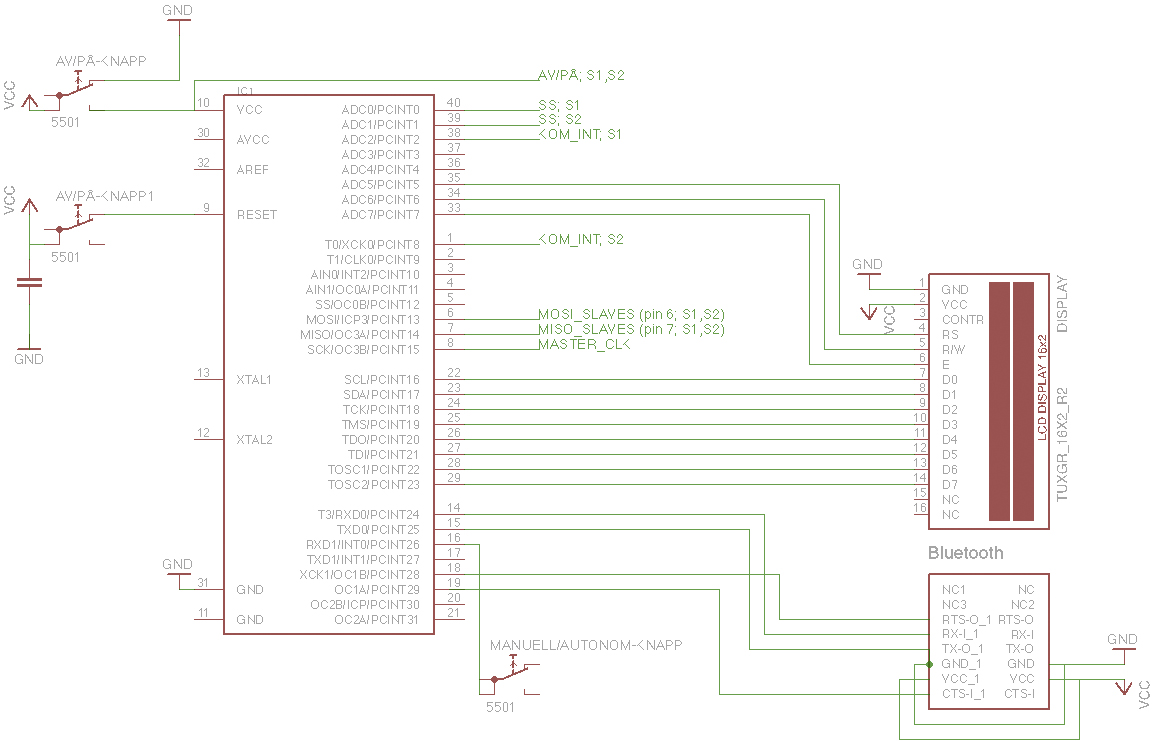
Designspec/komschema.jpg
