hansfilipelo/Kandidadprojekt/Skrivuppgifter/Kappa/frontview.jpg

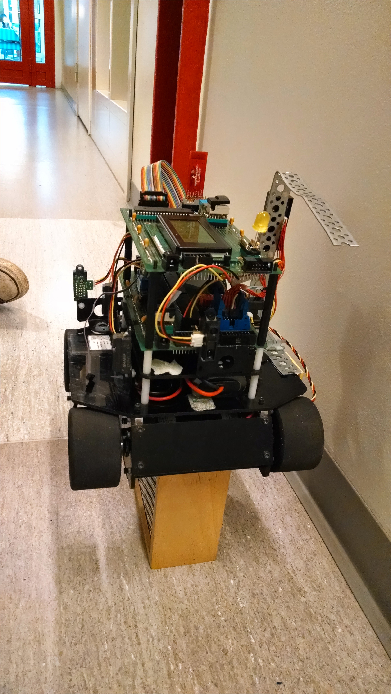
Skrivuppgifter/Kappa/frontview.jpg
