hansfilipelo/Kandidadprojekt/Skrivuppgifter/Kappa/lcd.jpg

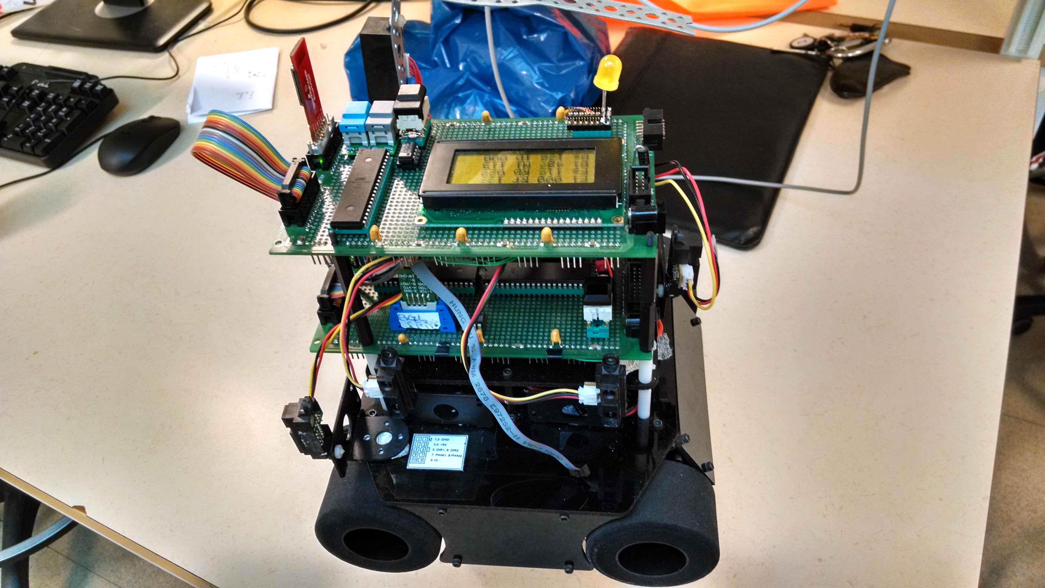
Skrivuppgifter/Kappa/lcd.jpg
