hansfilipelo/Kandidadprojekt/Skrivuppgifter/Kappa/moduler.jpg

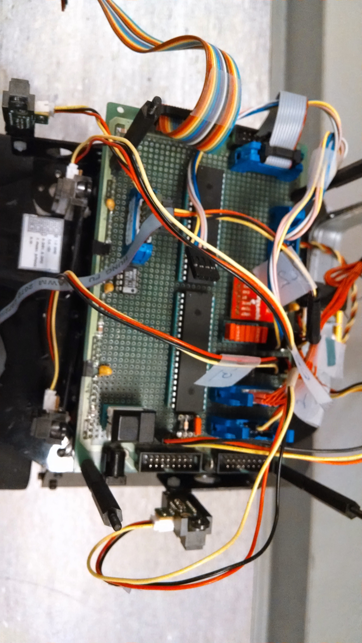
Skrivuppgifter/Kappa/moduler.jpg
