hansfilipelo/Kandidadprojekt/Skrivuppgifter/Kappa/sideview.jpg

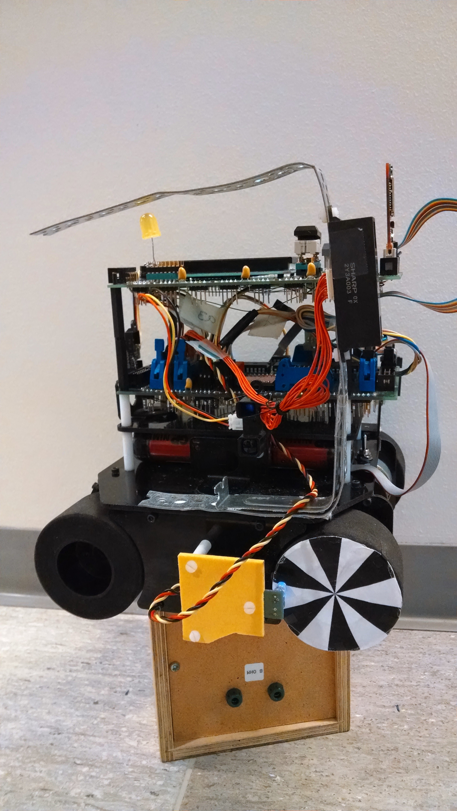
Skrivuppgifter/Kappa/sideview.jpg
