hansfilipelo/Kandidadprojekt/Skrivuppgifter/Sensorer/New Sensor/BodePlot Justerat system.jpg

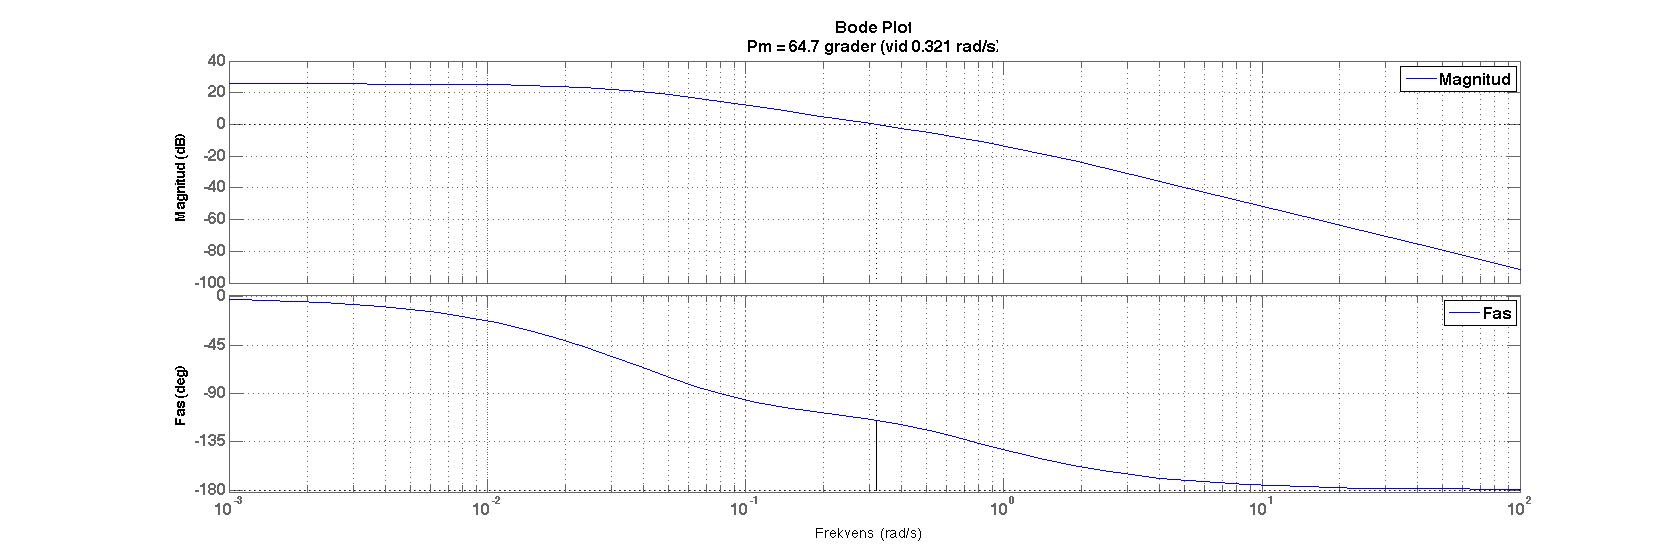
Skrivuppgifter/Sensorer/New Sensor/BodePlot Justerat system.jpg
