hansfilipelo/Kandidadprojekt/Skrivuppgifter/Sensorer/New Sensor/BodeplotSlutgiltig.jpg

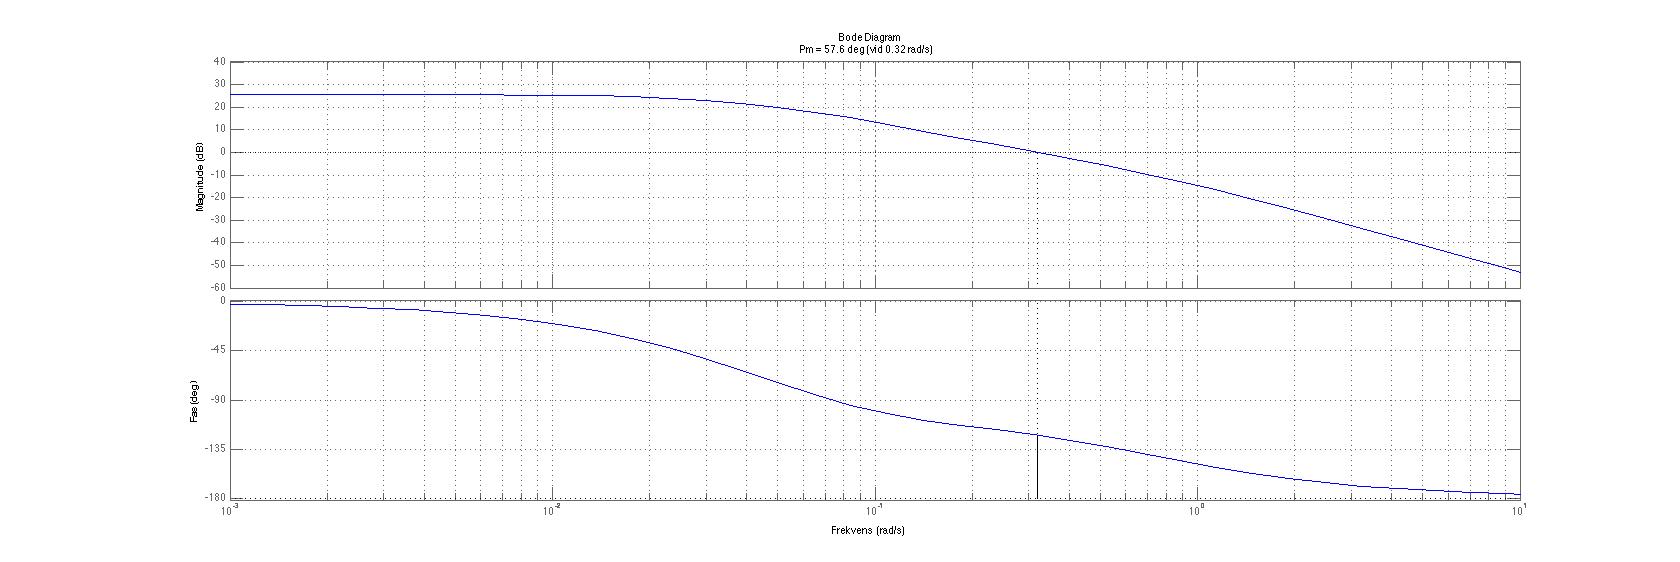
Skrivuppgifter/Sensorer/New Sensor/BodeplotSlutgiltig.jpg
