hansfilipelo/Kandidadprojekt/Skrivuppgifter/Sensorer/New Sensor/Coriolisjord.png

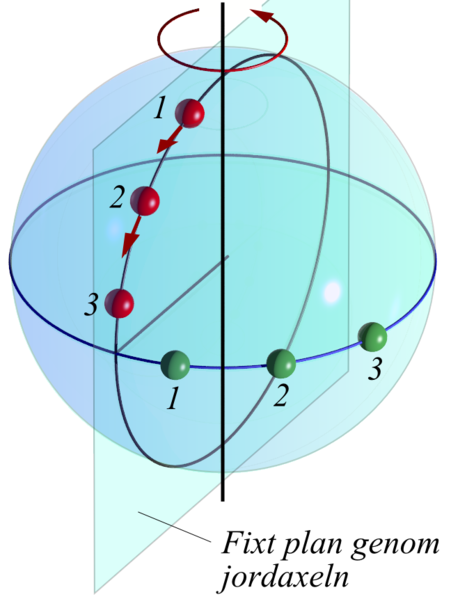
Skrivuppgifter/Sensorer/New Sensor/Coriolisjord.png
