hansfilipelo/Kandidadprojekt/Skrivuppgifter/Sensorer/New Sensor/gyro.jpeg

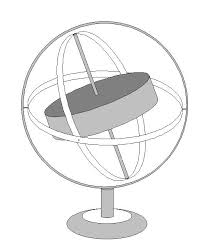
Skrivuppgifter/Sensorer/New Sensor/gyro.jpeg
