hansfilipelo/Kandidadprojekt/Skrivuppgifter/Teknisk_Dokumentation/bilder/robotbilder/Hela roboten_nr2.jpg

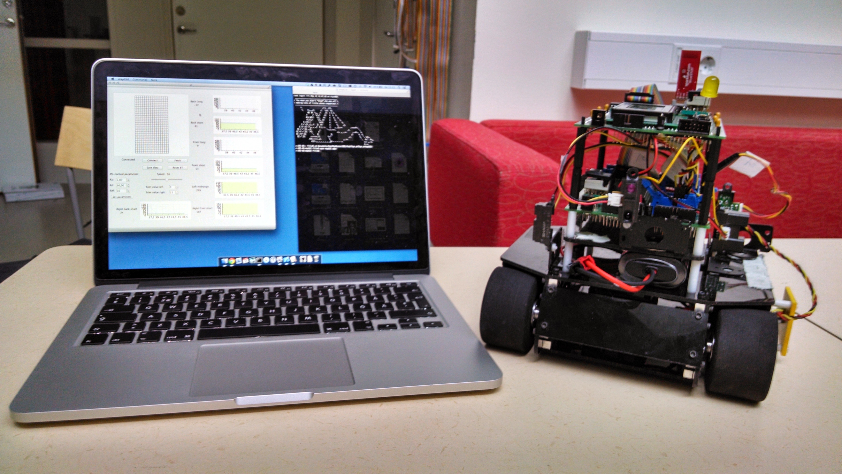
Skrivuppgifter/Teknisk_Dokumentation/bilder/robotbilder/Hela roboten_nr2.jpg
