hansfilipelo/Kandidadprojekt/Skrivuppgifter/Teknisk_Dokumentation/bilder/robotbilder/Sockel1.jpg

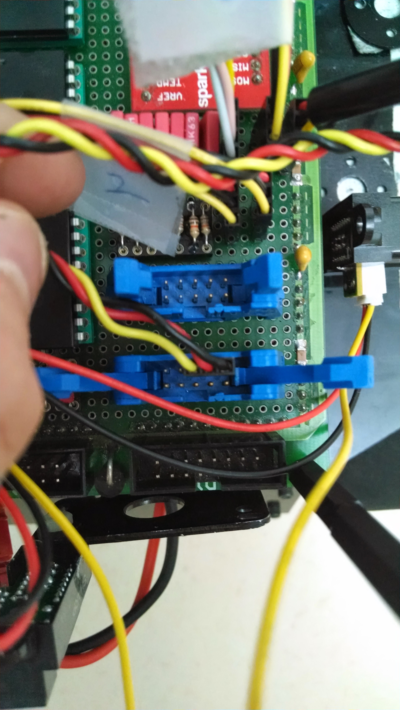
Skrivuppgifter/Teknisk_Dokumentation/bilder/robotbilder/Sockel1.jpg
