hansfilipelo/Kandidadprojekt/Skrivuppgifter/Teknisk_Dokumentation/bilder/robotbilder/Sockel1_nr2.jpg

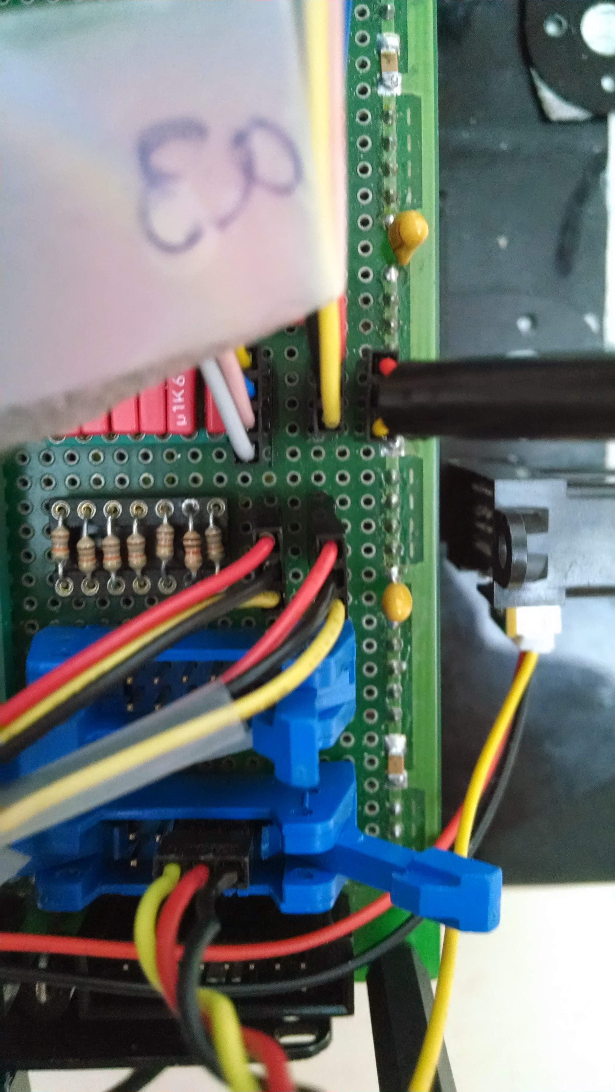
Skrivuppgifter/Teknisk_Dokumentation/bilder/robotbilder/Sockel1_nr2.jpg
