hansfilipelo/Kandidadprojekt/Skrivuppgifter/Teknisk_Dokumentation/bilder/robotbilder/Sockel1_nr3.jpg

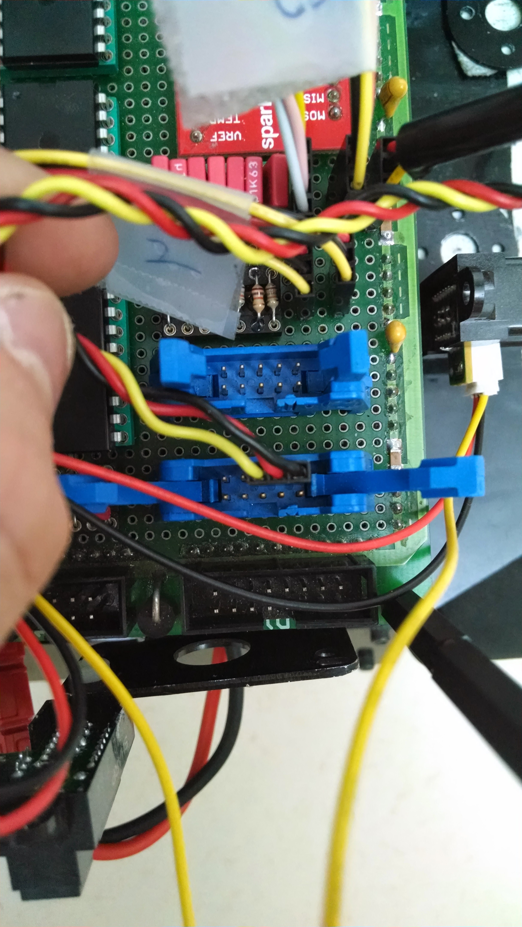
Skrivuppgifter/Teknisk_Dokumentation/bilder/robotbilder/Sockel1_nr3.jpg
