hansfilipelo/Kandidadprojekt/Skrivuppgifter/Teknisk_Dokumentation/bilder/robotbilder/Sockel1_tom.jpg

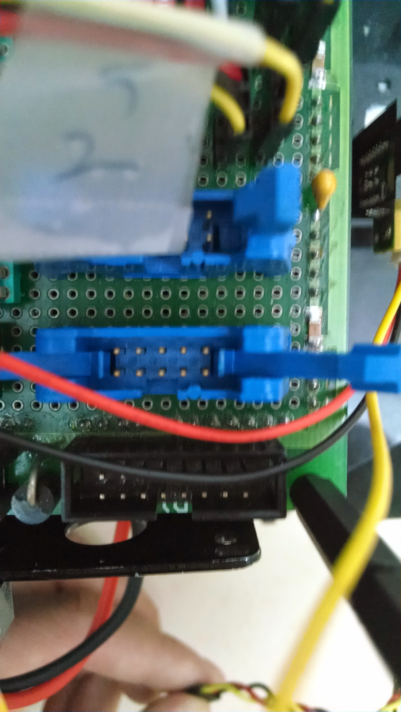
Skrivuppgifter/Teknisk_Dokumentation/bilder/robotbilder/Sockel1_tom.jpg
