hansfilipelo/Kandidadprojekt/Skrivuppgifter/Teknisk_Dokumentation/bilder/robotbilder/Sockel2.jpg

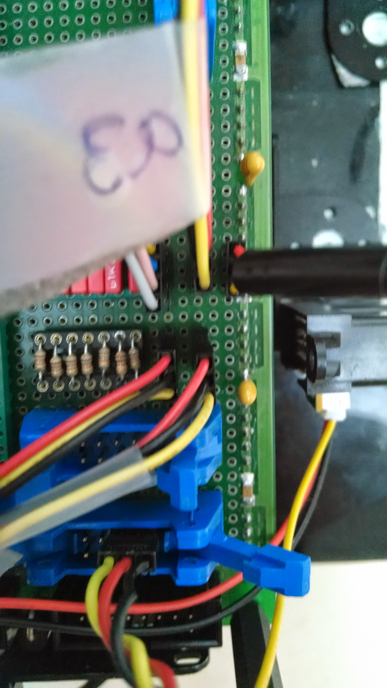
Skrivuppgifter/Teknisk_Dokumentation/bilder/robotbilder/Sockel2.jpg
