hansfilipelo/Kandidadprojekt/Skrivuppgifter/Teknisk_Dokumentation/bilder/robotbilder/Sockel2och3.jpg

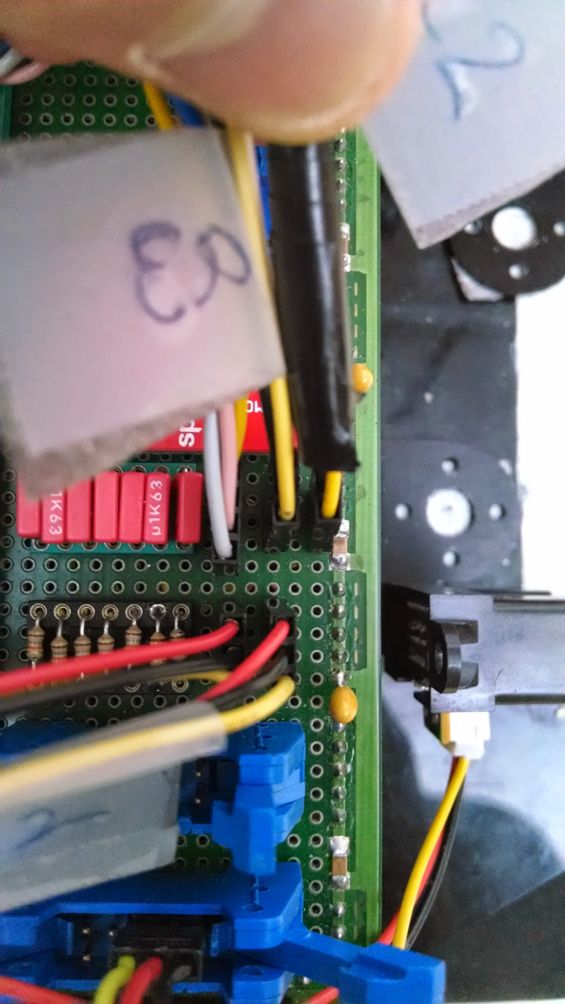
Skrivuppgifter/Teknisk_Dokumentation/bilder/robotbilder/Sockel2och3.jpg
