hansfilipelo/Kandidadprojekt/Skrivuppgifter/Teknisk_Dokumentation/bilder/robotbilder/Sockel2och3_nr2.jpg

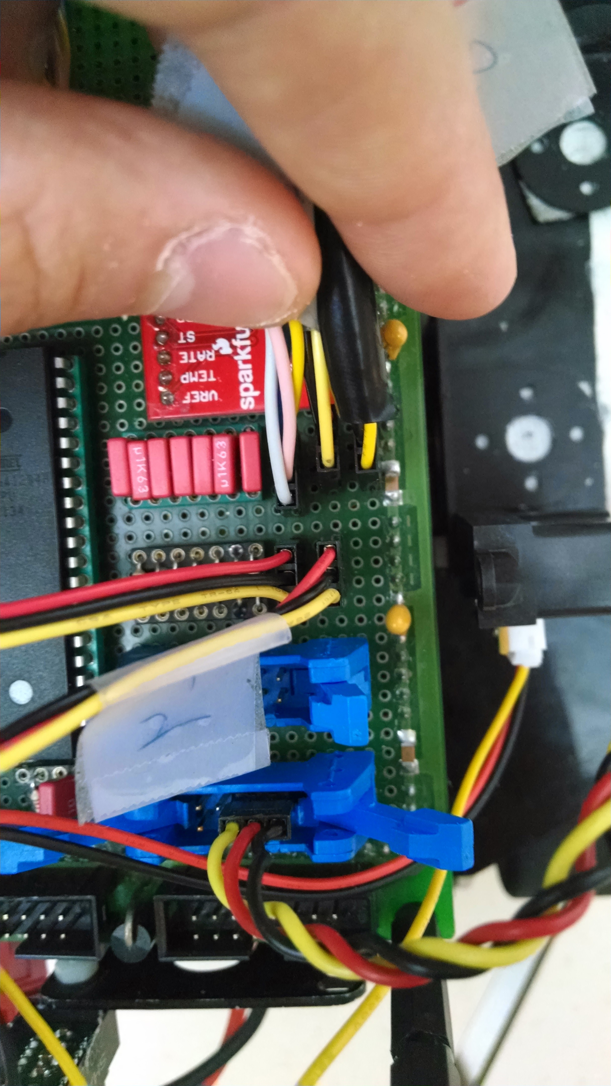
Skrivuppgifter/Teknisk_Dokumentation/bilder/robotbilder/Sockel2och3_nr2.jpg
