hansfilipelo/Kandidadprojekt/Skrivuppgifter/Teknisk_Dokumentation/bilder/robotbilder/Sockel3.jpg

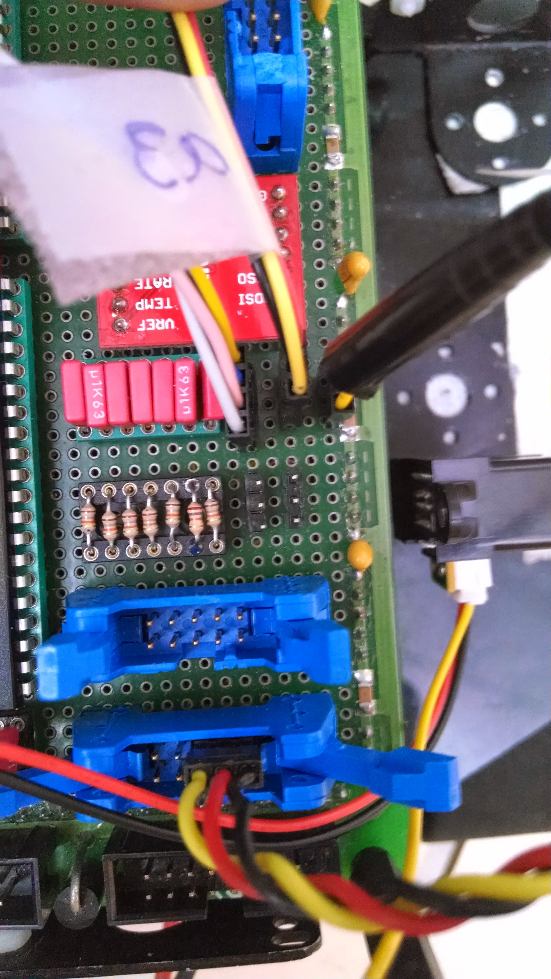
Skrivuppgifter/Teknisk_Dokumentation/bilder/robotbilder/Sockel3.jpg
