hansfilipelo/Kandidadprojekt/Skrivuppgifter/Teknisk_Dokumentation/bilder/robotbilder/Sockel3_nr2.jpg

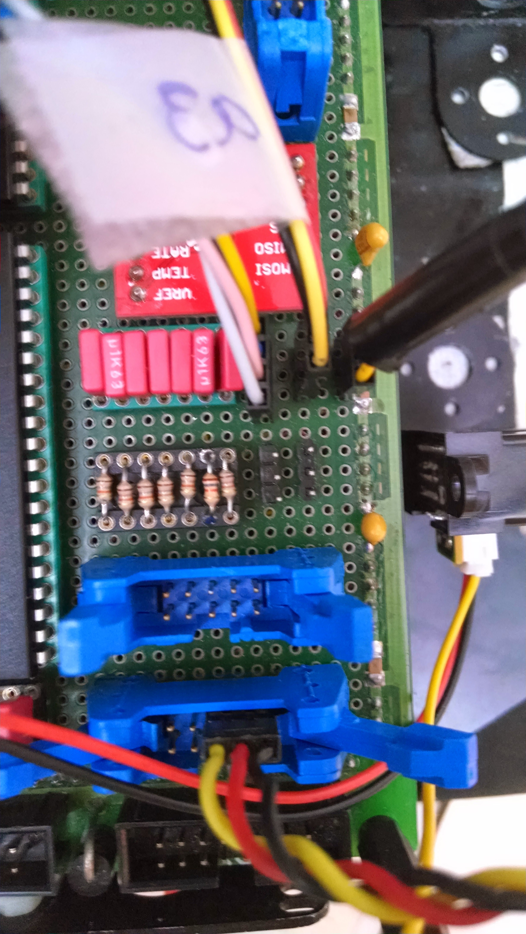
Skrivuppgifter/Teknisk_Dokumentation/bilder/robotbilder/Sockel3_nr2.jpg
