hansfilipelo/Kandidadprojekt/Skrivuppgifter/Teknisk_Dokumentation/bilder/robotbilder/Sockel3_tom.jpg

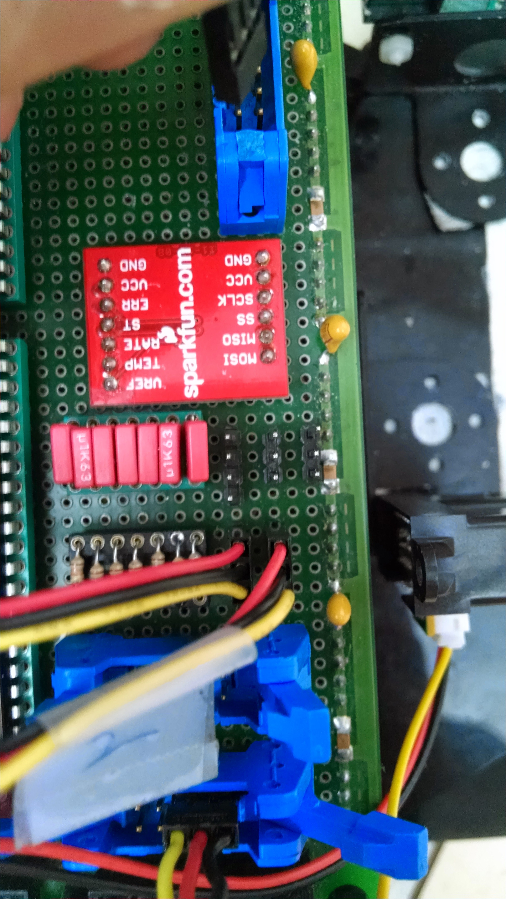
Skrivuppgifter/Teknisk_Dokumentation/bilder/robotbilder/Sockel3_tom.jpg
