hansfilipelo/Kandidadprojekt/Skrivuppgifter/Teknisk_Dokumentation/bilder/robotbilder/Sockel4.jpg

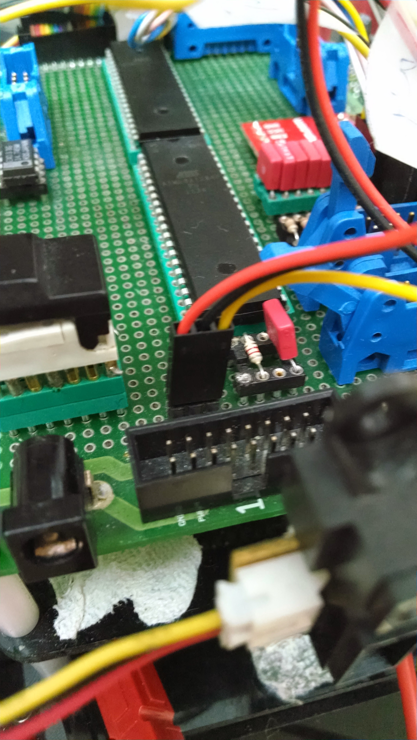
Skrivuppgifter/Teknisk_Dokumentation/bilder/robotbilder/Sockel4.jpg
