hansfilipelo/Kandidadprojekt/Skrivuppgifter/Teknisk_Dokumentation/bilder/robotbilder/Sockel4_tom.jpg

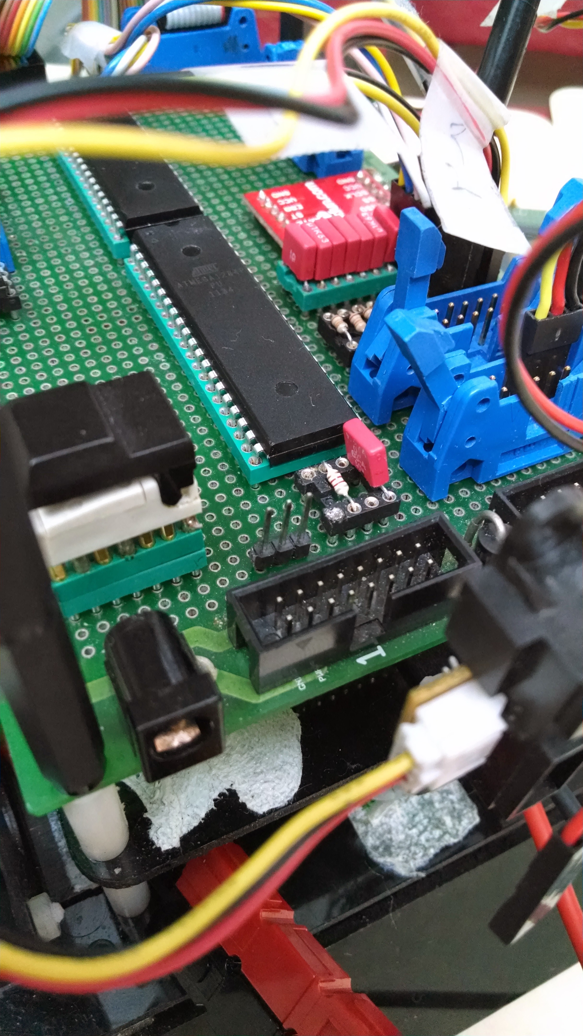
Skrivuppgifter/Teknisk_Dokumentation/bilder/robotbilder/Sockel4_tom.jpg
