hansfilipelo/Kandidadprojekt/Skrivuppgifter/Teknisk_Dokumentation/bilder/robotbilder/Sockel4_tom_nr2.jpg

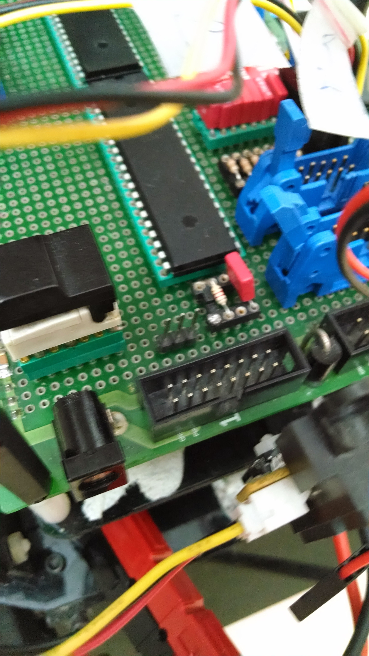
Skrivuppgifter/Teknisk_Dokumentation/bilder/robotbilder/Sockel4_tom_nr2.jpg
