hansfilipelo/Kandidadprojekt/Skrivuppgifter/Teknisk_Dokumentation/bilder/sensorflode.jpg

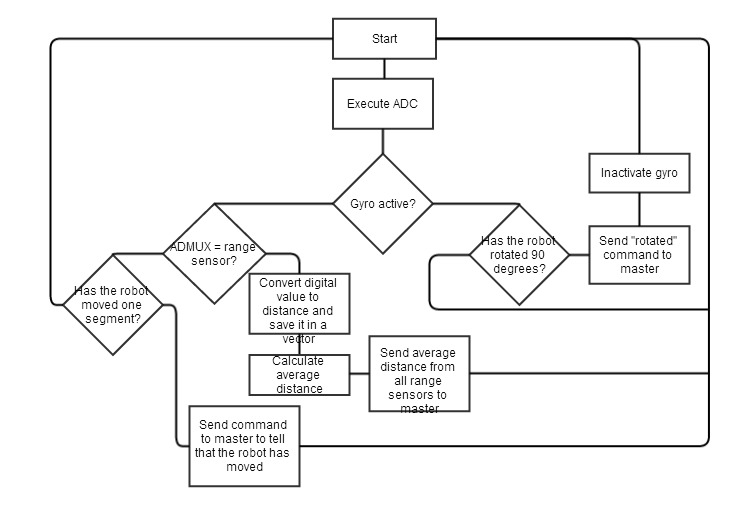
Skrivuppgifter/Teknisk_Dokumentation/bilder/sensorflode.jpg
