hansfilipelo/Kandidadprojekt/Skrivuppgifter/Teknisk_Dokumentation/bilder/sensormodulkoppling.jpg

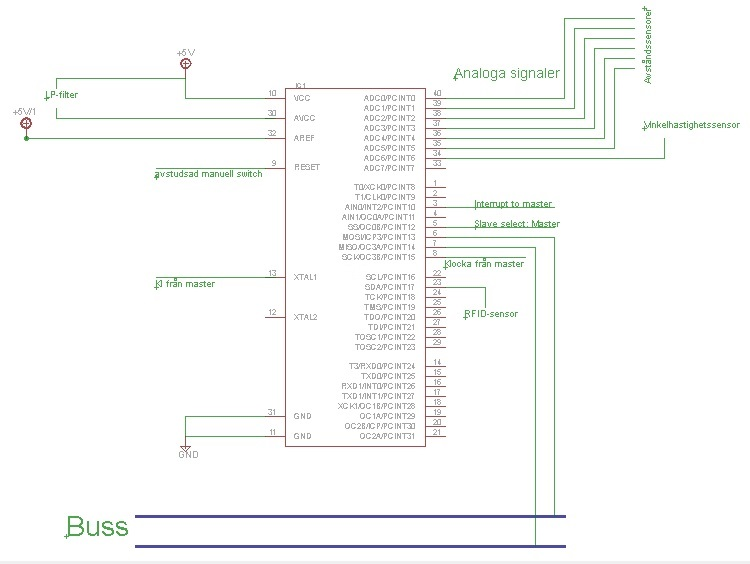
Skrivuppgifter/Teknisk_Dokumentation/bilder/sensormodulkoppling.jpg
