hansfilipelo/Kandidadprojekt/Skrivuppgifter/Teknisk_Dokumentation/bilder/SPIbild001.jpg

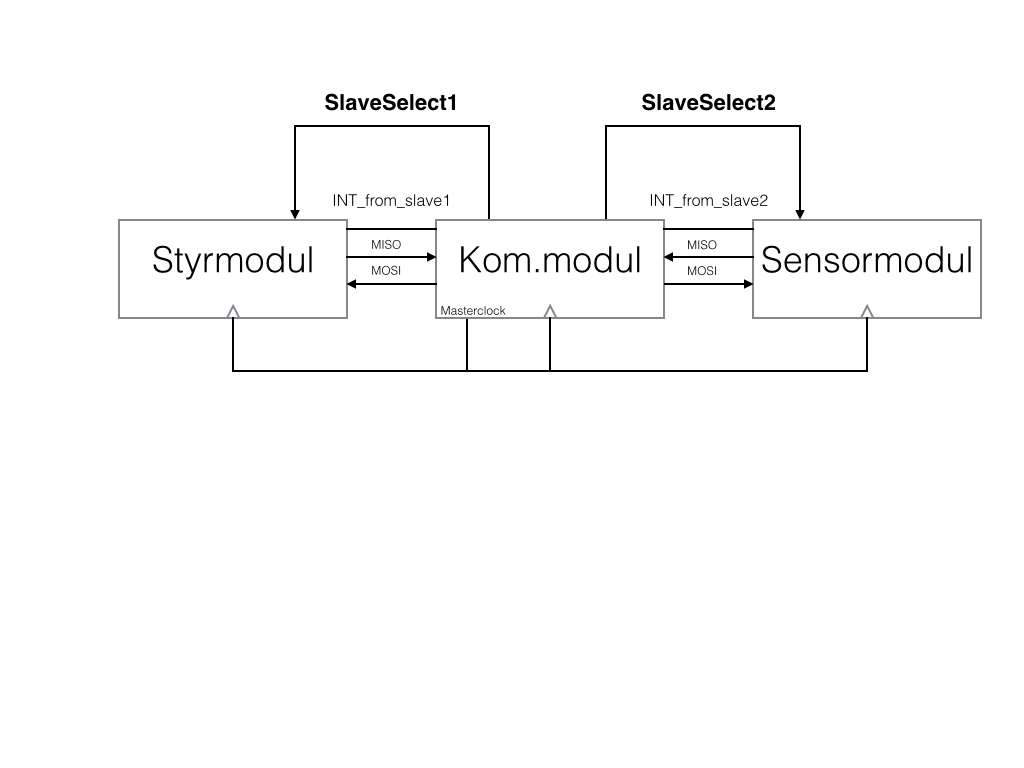
Skrivuppgifter/Teknisk_Dokumentation/bilder/SPIbild001.jpg
