hansfilipelo/Kandidadprojekt/Skrivuppgifter/Teknisk_Dokumentation/bilder/Kom_modul_uptodate.sch

## EAGLE design Skrivuppgifter/Teknisk_Dokumentation/bilder/Kom_modul_uptodate.sch (2014-05-16)

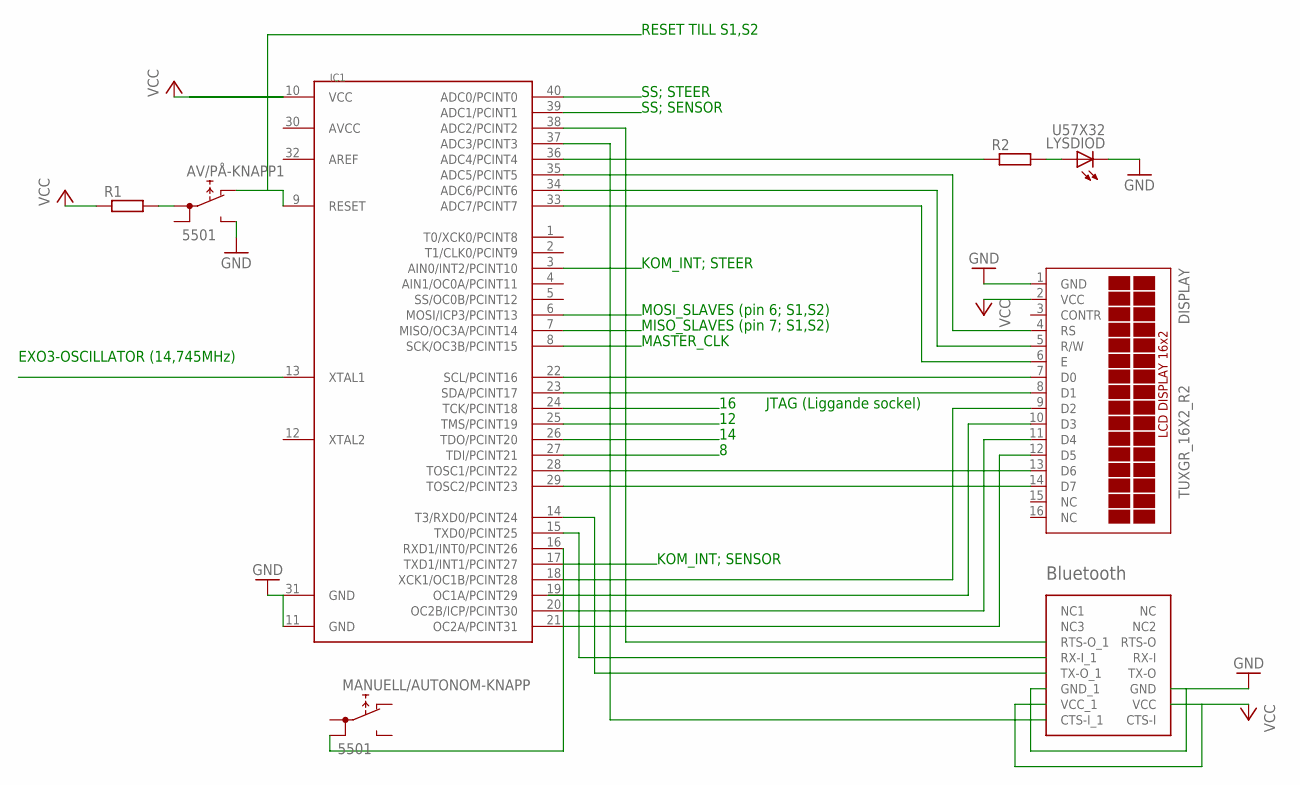
[picture p86: schematic Kom_modul_uptodate.sch]

Parts:
AV/PÅ-KNAPP1: 5501
DISPLAY: TUXGR_16X2_R2
IC1: MEGA1284P; DIL40
LYSDIOD: U57X32
MANUELL/AUTONOM-KNAPP: 5501
R1, R2: R-EU_0309/V; 0309V
U$1: BLUETOOTH

Connections:
GND: AV/PÅ-KNAPP1.NO, DISPLAY.1 (GND), IC1.11 (GND), IC1.31 (GND), LYSDIOD.K (C), U$1.GND, U$1.GND_1
unnamed: IC1.39 (ADC1/PCINT1), U$1.RTS-O (RTS-O_1)
unnamed: DISPLAY.7 (D0), DISPLAY.8 (D1), DISPLAY.9 (D2), DISPLAY.10 (D3), DISPLAY.11 (D4), DISPLAY.12 (D5), IC1.18 (XCK1/OC1B/PCINT28), IC1.20 (OC2B/ICP/PCINT30), IC1.21 (OC2A/PCINT31), IC1.22 (SCL/PCINT16)
unnamed: AV/PÅ-KNAPP1.NC, IC1.9 (RESET)
unnamed: DISPLAY.4 (RS), IC1.35 (ADC5/PCINT5)
unnamed: DISPLAY.5 (R/W), IC1.34 (ADC6/PCINT6)
unnamed: DISPLAY.6 (E), IC1.33 (ADC7/PCINT7)
unnamed: AV/PÅ-KNAPP1.1A, R1.2
unnamed: IC1.16 (RXD1/INT0/PCINT26), MANUELL/AUTONOM-KNAPP.1B
unnamed: LYSDIOD.A, R2.2
unnamed: IC1.36 (ADC4/PCINT4), R2.1
unnamed: DISPLAY.13 (D6), IC1.28 (TOSC1/PCINT22)
unnamed: DISPLAY.14 (D7), IC1.29 (TOSC2/PCINT23)
unnamed: IC1.15 (TXD0/PCINT25), U$1.RX-O_1 (RX-I_1)
unnamed: IC1.14 (T3/RXD0/PCINT24), U$1.TX-O_1
unnamed: IC1.37 (ADC3/PCINT3), U$1.CTS-I_1
VCC: DISPLAY.2 (VCC), R1.1, U$1.VCC, U$1.VCC_1

Notes on the sheet:
MISO_SLAVES (pin 7; S1,S2)
MASTER_CLK
MOSI_SLAVES (pin 6; S1,S2)
SS; SENSOR
SS; STEER
KOM_INT; SENSOR
KOM_INT; STEER
EXO3-OSCILLATOR (14,745MHz)
JTAG (Liggande sockel)
RESET TILL S1,S2
