hansfilipelo/Kandidadprojekt/Kod/Styr_m/Styr_m/Map.cpp

#include "./Map.h"
#include "./MapSection.h"

using namespace std;

// ------------- Construct -----------------

Map::Map(){
	
	// Create 32 X by 17 Y
    for (int it = 0; it < 17; it++) {
        for (int i = 0; i < 32; i++) {
            mapArea[i][it] = new MapSection(i,it,this); // it, i to i, it
        }
    }
}

void Map::fillUnexplored()
{
	for (int x = 0; x < 32; x++)
	{
		for (int y = 0; y < 17; y++)
		{
			if (this->getPos(x,y)->getType() == 'u')
			{
				this->convertSection(x,y,'e');
			}
		}
	}
}

// -----------------------------------------

Map::~Map(){
    
    for (int it = 0; it < 17; it++) {
        for (int i = 0; i < 32; i++) {
            delete mapArea[i][it];
        }
    }
}

bool Map::getVisited(int xPos,int yPos){
    return mapArea[xPos][yPos]->isVisited;
	
}


void Map::convertToPathFinding(){
	for (int it = 0; it < 17; it++) {
		for (int i = 0; i < 32; i++) {
			if (this->getPos(i,it)->getType() == 'c') {
				pathMap[i][it] = 1;
			}
			else{
				pathMap[i][it] = 0;
			}
		}
	}
}

// A-star algorithm.
// The route returned is a string of direction digits.
/**********************************************************************
    The code was downloaded from http://code.activestate.com/recipes/577457-a-star-shortest-path-algorithm/
    and then modified to fit our map and robot.
    The queueAtmel class is a replica of stdlib c++ <priority_queue>, 
    but modified to compile on atmega 1284p.
 **********************************************************************/

void Map::aStar(int xStart,int yStart,int xFinish,int yFinish)
{
	const int n=32; // horizontal size of the map
	const int m=17; // vertical size size of the map
	static int closed_nodes_map[n][m]; // map of closed (tried-out) nodes
	static int open_nodes_map[n][m]; // map of open (not-yet-tried) nodes
	static int dir_map[n][m]; // map of directions
	const int dir=4; // number of possible directions to go at any position
	static int dx[dir]={1, 0, -1, 0};
	static int dy[dir]={0, 1, 0, -1};
	
	queueAtmel pqA[2]; // list of open (not-yet-tried) nodes
	
	static int pqi; // pq index
	static node* n0;
    static node* n2;
    static node* m0;
	static int i, j, x, y, xdx, ydy;
	static int c;
	pqi=0;
	
	// reset the node maps
	for(y=0;y<m;y++)
	{
		for(x=0;x<n;x++)
		{
			closed_nodes_map[x][y]=0;
			open_nodes_map[x][y]=0;
		}
	}
	
	// create the start node and push into list of open nodes
  
	node tmp2(xStart, yStart, 0, 0);
    n2 = &tmp2;
	n2->updatePriority(xFinish, yFinish);
	pqA[pqi].Apush(*n2);
    
	open_nodes_map[x][y]=n2->getPriority(); // mark it on the open nodes map
	
	// A* search
	while(!pqA[pqi].Aempty())
	{
		// get the current node w/ the highest priority
		// from the list of open nodes
		node tmp( pqA[pqi].Atop().getxPos(), pqA[pqi].Atop().getyPos(),pqA[pqi].Atop().getLevel(), pqA[pqi].Atop().getPriority());
        n0 = &tmp;
        
		x=n0->getxPos(); y=n0->getyPos();
		
		pqA[pqi].Apop(); // remove the node from the open list
		open_nodes_map[x][y]=0;
		// mark it on the closed nodes map
		closed_nodes_map[x][y]=1;
		
		// quit searching when the goal state is reached
		//if((*n0).estimate(xFinish, yFinish) == 0)
		if(x==xFinish && y==yFinish)
		{
			int counter = 0;
			
			while(!(x==xStart && y==yStart))
			{
				j=dir_map[x][y];
				c=(int)(j+dir/2)%dir;
				
				switch (c) {
					case 0 : pathArray[counter] = 'l';
                        break;
					case 1 : pathArray[counter] = 'f';
                        break;
					case 2 : pathArray[counter] = 'r';
                        break;
					case 3 : pathArray[counter] = 'b';
                        break;
					default:
                        break;
				}
				x+=dx[j];
				y+=dy[j];
				counter++;
			}
			
			int size = counter + 1;
			char reversedArray[size];
			char charSize = 48 + counter;
			reversedArray[0]=charSize;
			for (int k=1; k < size; k++){
				reversedArray[size-k] = pathArray[k-1];
			}
            
			memcpy(pathArray,reversedArray,size);
			// garbage collection
			n0=NULL;
			// empty the leftover nodes
			while(!pqA[pqi].Aempty()) pqA[pqi].Apop();
			return;
		}
		
		// generate moves (child nodes) in all possible directions
		for(i=0;i<dir;i++)
		{
			xdx=x+dx[i]; ydy=y+dy[i];
			
			if(!(xdx<0 || xdx>n-1 || ydy<0 || ydy>m-1 || pathMap[xdx][ydy]==1 || closed_nodes_map[xdx][ydy]==1))
			{
				// generate a child node
				m0 = new node( xdx, ydy, n0->getLevel(),n0->getPriority());
                
				m0->nextLevel(i);
				m0->updatePriority(xFinish, yFinish);
				
				// if it is not in the open list then add into that
				if(open_nodes_map[xdx][ydy]==0)
				{
					open_nodes_map[xdx][ydy]=m0->getPriority();
					pqA[pqi].Apush(*m0);
					// mark its parent node direction
					dir_map[xdx][ydy]=(i+dir/2)%dir;
				}
				else if(open_nodes_map[xdx][ydy]>m0->getPriority())
				{
					// update the priority info
					open_nodes_map[xdx][ydy]=m0->getPriority();
					// update the parent direction info
					dir_map[xdx][ydy]=(i+dir/2)%dir;
					
					// replace the node
					// by emptying one pq to the other one
					// except the node to be replaced will be ignored
					// and the new node will be pushed in instead
                    while(!(pqA[pqi].Atop().getxPos()==xdx && pqA[pqi].Atop().getyPos()==ydy))
					{
						pqA[1-pqi].Apush(pqA[pqi].Atop());
						pqA[pqi].Apop();
					}
					pqA[pqi].Apop(); // remove the wanted node
					
					// empty the larger size pq to the smaller one
					if(pqA[pqi].Asize()>pqA[1-pqi].Asize()){
                        pqi=1-pqi;
                    }
					while(!pqA[pqi].Aempty())
					{
						pqA[1-pqi].Apush(pqA[pqi].Atop());
						pqA[pqi].Apop();
					}
					pqi=1-pqi;
					pqA[pqi].Apush(*m0); // add the better node instead
				}
				else delete m0; // garbage collection
			}
		}
		n0=NULL; // garbage collection
	}
	pathArray[0]='F';
	return;
}


void Map::setVisited(int xPos,int yPos,bool value){
    mapArea[xPos][yPos]->isVisited = value;
}


// ------------------------------------------

MapSection* Map::getPos(int x, int y){
    return mapArea[x][y];
}

// ------------------------------------------

void Map::setSection(int xPos, int yPos, MapSection* inSection){
    mapArea[xPos][yPos] = inSection;
}

// ------------------------------------------

void Map::convertSection(int xPos, int yPos, char inType){
	this->getPos(xPos,yPos)->setType(inType);
}

void Map::getColAsChar(int col)
{
	
	
	// Sending 19 positions of interest
	colArray[0] = 23;
	// Sending Map data command
	colArray[1] = 'M';
	// Sending column number
	colArray[2] = col;
    
	for (int it = 0; it < 17; it++)
	{
		// Type of the block we are looking at
		colArray[it+3] = this->getPos(col,it)->getType();
	}
}


// Fills closed area if closed

void Map::fillClosedArea()
{
	for (int y = 0; y < 17; y++) {
		if(this->getPos(0,y)->getType() == 'u'){
			this->getPos(0,y)->cancer();
			return;
		}
		else if (this->getPos(31,y)->getType() == 'u')
		{
			this->getPos(31,y)->cancer();
			return;
		}
        
    }
    
}
//-----------------------------------
// Checks if coordinates within map

bool Map::withinMap(int xPos, int yPos){
    if (xPos < 0 || xPos > 31 || yPos < 0 || yPos > 16) {
        return false;
    }
    else {
        return true;
    }
}


// -------------------- TESTING --------------------

#if TESTING == 1
void Map::printMap(){
    for (int it = 0; it < 17; it++) {
        for (int i = 0; i < 32; i++) {
            cout << this->getPos(i,it)->getType() << " ";
        }
        cout << endl;
    }
}

void Map::printPathMap(){
    for (int it = 0; it < 17; it++) {
        for (int i = 0; i < 32; i++) {
            cout << pathMap[i][it] << " ";
        }
        cout << endl;
    }
}

void Map::initMap(){
    char tempMap[32][17]={
        {'u','u','u','u','u','u','u','u','u','u','u','u','u','u','u','u','u'},
        {'u','u','u','u','u','u','u','u','u','u','u','u','u','u','u','u','u'},
        {'u','u','u','u','u','u','u','u','u','u','u','u','u','u','u','u','u'},
        {'u','u','u','u','u','u','u','u','u','u','u','u','u','u','u','u','u'},
        {'u','u','u','u','u','u','u','u','u','u','u','u','u','u','u','u','u'},
        {'u','u','u','u','u','u','u','u','u','u','u','u','u','u','u','u','u'},
        {'u','u','u','u','u','u','u','u','u','u','u','u','u','u','u','u','u'},
        {'u','u','u','u','u','u','u','u','u','u','u','u','u','u','u','u','u'},
        {'u','u','u','u','u','u','u','u','u','u','u','u','u','u','u','u','u'},
        {'u','u','u','u','u','u','u','u','u','u','u','u','u','u','u','u','u'},
        {'u','u','u','u','u','u','u','u','u','u','u','u','u','u','u','u','u'},
        {'u','u','u','u','u','u','u','u','u','u','u','u','u','u','u','u','u'},
        {'u','u','u','u','u','u','u','u','u','u','u','u','u','u','u','u','u'},
        {'u','u','u','u','u','u','u','u','u','u','u','u','u','u','u','u','u'},
        {'u','u','u','u','u','u','u','u','u','u','u','u','u','u','u','u','u'},
        {'u','c','c','c','c','c','c','c','c','c','c','c','c','c','c','u','u'},
        {'u','u','u','u','u','u','u','u','u','u','u','u','u','u','u','u','u'},
        {'u','u','u','u','u','u','u','u','u','u','u','u','u','u','u','u','u'},
        {'u','u','u','u','u','u','u','u','u','u','u','u','u','u','u','u','u'},
        {'u','u','u','u','u','u','u','u','u','u','u','u','u','u','u','u','u'},
        {'u','u','u','u','u','u','u','u','u','u','u','u','u','u','u','u','u'},
        {'u','u','u','u','u','u','u','u','u','u','u','u','u','u','u','u','u'},
        {'u','u','u','u','u','u','u','u','u','u','u','u','u','u','u','u','u'},
        {'u','u','u','u','u','u','u','u','u','u','u','u','u','u','u','u','u'},
        {'u','u','u','u','u','u','u','u','u','u','u','u','u','u','u','u','u'},
        {'u','u','u','u','u','u','u','u','u','u','u','u','u','u','u','u','u'},
        {'u','u','u','u','u','u','u','u','u','u','u','u','u','u','u','u','u'},
        {'u','u','u','u','u','u','u','u','u','u','u','u','u','u','u','u','u'},
        {'u','u','u','u','u','u','u','u','u','u','u','u','u','u','u','u','u'},
        {'u','u','u','u','u','u','u','u','u','u','u','u','u','u','u','u','u'},
        {'u','u','u','u','u','u','u','u','u','u','u','u','u','u','u','u','u'},
        {'u','u','u','u','u','u','u','u','u','u','u','u','u','u','u','u','u'},
    };
    
    for (int it = 0; it < 17; it++) {
        for (int i = 0; i < 32; i++) {
            mapArea[i][it] = new MapSection(i,it,this); // it, i to i, it
            
            if (tempMap[i][it] == 'c') {
                this->getPos(i,it)->setType('c');
            }
            if (tempMap[i][it] == 'e') {
                this->getPos(i,it)->setType('e');
            }
        }
    }
}

// ------------------------------
// After finish - do this





#endif
