hansfilipelo/Kandidadprojekt/Kod/Styr_m/Styr_m/node.h

/*
 File: node.h
 Purpose: Class helping A-star algorithm. Not implemented on robot.
 */


#ifndef NODE
#define NODE

#include <math.h>


class node
{    
    // current position
    int xPos;
    int yPos;
    // total distance already travelled to reach the node
    int level;
    // priority=level+remaining distance estimate
    int priority;  // smaller: higher priority
    int dir = 4;
    
public:
    node(int xp, int yp, int d, int p){xPos=xp; yPos=yp; level=d; priority=p;}
    
    int getxPos() const {return xPos;}
    int getyPos() const {return yPos;}
    int getLevel() const {return level;}
    int getPriority() const {return priority;}
    void updatePriority(const int & xDest, const int & yDest);
    void nextLevel(const int & i);
    const int & estimate(const int & xDest, const int & yDest);
    
};



#endif
