hansfilipelo/Kandidadprojekt/Kod/Styr/STYR/STYR/Communication.cpp

#include "Communication.h"
#include "../../../sensormodul/sensormodul/slave.h"
#include "MapSection.h"

Communication::Communication(Slave* pointer){
    slavePointer=pointer;
}

void Communication::handleData(){
    for (int i=0;i<25;i++){
        inData[i]=slavePointer->inDataArray[i];
    }
    dataLength = (int)inData[0];
    if (inData[1]=='r' && inData[2]==0) {
        robotPointer->rotateLeft();
    }
    if (inData[1]=='r' && inData[2]==1) {
        robotPointer->rotateRight();
    }
    if (inData[1]=='f'){
        int speed =(int)inData[3];
        robotPointer->driveForward(speed);
    }
    if (inData[1]=='b'){
        int speed =(int)inData[3];
        robotPointer->driveBackward(speed);
    }
    
    // Do stuff with sensor values
}

// -------------------

void Communication::setRobot(Robot* inRobot){
    robotPointer = inRobot;
}

// -------------------

void Communication::sendMap(){
    for (int i = 0; i < 32; i++) {
        char* sendData = robotPointer->getColAsChar(i);
        
        for (int i = 0; i < 20; i++) {
            slavePointer->outDataArray[i] = sendData[i];
        }
    }
}
