hansfilipelo/Kandidadprojekt/(commit log)

2014-02-27 la till .pdf
2014-02-28 Lagt till text om sensormodul
2014-02-28 la till busstrefik
2014-02-28 Lagt till en bild på sensormodulen
2014-02-28 Lagt till en överblicksbild av sensormodulen
2014-02-28 la till bilder
2014-03-01 Lagt till kopplingsschema på sensormodulen
2014-03-02 felstavning och meningsbyggnad i sensordelen
2014-03-02 FEl i hänvisning till en bild på sensordelen
2014-03-23 la till mall för kom-skrivuppgift
2014-03-24 Gjort komponentlista för sensormodulen
2014-03-24 Lite odometri - kladd
2014-03-24 Flyttat KF-filter
2014-03-25 Added sensor.tex
2014-03-26 Uppdate av sensor
2014-03-26 Fixat fotnoter på skrivuppgiften för sensor
2014-03-27 First code for steering. Ready for testing!
2014-03-27 Corrected interrupts
2014-03-28 Activates more registers in order to activate PWM.
    Hopefully it works.
2014-03-28 PWM now works. Need testing on robot
2014-03-28 50% power on PWM
2014-03-28 Modified program, it now sends the char A to AVR processor. And if the processor is running current version of BlueTooth1.cpp AVR processor will send [A] back to computer
2014-04-01 Early coding stage. Coderage!
2014-04-01 Komplettering av sensorfördjupning
2014-04-01 Replaced vector with array since AVR C++ libraries are very incomplete.
    [Map.h, STYR.cpp]
2014-04-02 Does not work since AVR string implementation isn't really C++ string ... It's just a collection of functions to work with chars...
    [Map.h, MapSection.h, STYR.cpp]
2014-04-03 Linker problems but a lot of good code in here.
    [Abstraction.cc, Map.h, MapSection.h]
2014-04-03 No fucking linker error!
    [STYR.cpp]
2014-04-04 Linker error again. Otherwise robot can now go to a wall in front of it and then start rotating and wait for stop-signal from sensor module
    [MapSection.cpp, MapSection.h]
2014-04-04 Removed linker error with map but now Abstraction.cpp is read more than one time
    [Abstraction.cpp, Map.h, MapSection.h, STYR.cpp]
2014-04-04 Created header file for Abstraction. Now no fkking linker error
    [Abstraction.cpp, Abstraction.h, Map.h, MapSection.h, STYR.cpp]
2014-04-07 Added print function which does not work
    [Map.cpp, Map.h, styrtest.cpp]
2014-04-08 Som testing and a lot of smaller code fixes
    [Abstraction.cpp, Abstraction.h, Map.cpp, Map.h, MapSection.cpp, MapSection.h, styrtest.cpp]
2014-04-08 Changes concerning gear, rotation and direction
2014-04-09 BT slight changes, not working with AVR
    [main.cpp, order.cpp, order.h, serialport.cpp, serialport.h]
2014-04-09 These files is not working properly, checking out earlier version for debugging
    [order.cpp, serialport.cpp]
2014-04-09 sensormodul med slaveklass
2014-04-09 Compiles with Atmel and steer+slave
2014-04-09 updaterat sensormodul
2014-04-09 fixat kartuppritning mha test arrays och en test data array
    [main.cpp]
2014-04-09 Fixed small (one mapsection) memory leak in Robot
    [MapSection.cpp]
2014-04-09 Still problems with pointers
    [STYR.cpp]
2014-04-09 Fewer errors but still some.
    [Abstraction.cpp, Abstraction.h, STYR.cpp]
2014-04-09 Only errors left in MapSection.cpp
    [Abstraction.h]
2014-04-10 Static gear and speed in Styr.cpp in order to avoid conflict with Robot
    [STYR.cpp]
2014-04-10 Does not compiles. Fix it.
    [order.cpp, order.h, serialport.cpp, serialport.h]
2014-04-10 Change in interrupt.
2014-04-10 serialports do not work while in gui file, reason unknown.
    [main.cpp]
2014-04-10 Update gui.cpp
    Added a comment, for what to try first tomorrow.
    Otherwise threading or using the serialport as the master are viable options.
2014-04-11 Small changes to bluetooth. Currently works
2014-04-11 Program will now reconnect to bluetooth if the connection fails. Added arrow key button support
    [main.cpp]
2014-04-11 Small change to gui, avoid crash when no BT
    [main.cpp, order.cpp]
2014-04-11 Compiles, can send to master and from there to slave. Note: only works under 5.1.1 and 5.3.0, will not work under 5.2.2
    [order.cpp]
2014-04-11 Pins for BT moved. Sensormodule does not react on, PIND anymore (intended). BT implemented in master file successfully.
2014-04-11 Corrected paths for debugging environment
    [styrtest.cpp]
2014-04-11 Removed non current versions
2014-04-14 Changed how PWM controls it's pins
2014-04-14 ecieves forward and back command. Drives wrong direction. Turns not wokring. And only one side drives
    [Communication.cpp, Styr_m.cpp]
2014-04-14 fixat lite i master
    [Communication.cpp, master.cpp]
2014-04-14 Removed Filtering sensor data
2014-04-14 Added code for manual/auto switch. Works. Also implemented speed
2014-04-14 Compiles with new sensor values and names
2014-04-15 Mapping functions written but not tested since no sensordata available.
2014-04-15 Created testcase for entering sensordata and it works.
2014-04-15 Sensordata correctly imports to robot in test environment.
    [Communication.cpp, MapSection.cpp, MapSection.h, styrtest.cpp]
2014-04-15 Gyro data included.
2014-04-15 Update to Steer and master for bus communication
2014-04-15 Trying to send Maps to PC, not working currently
    [Communication.cpp, Styr_m.cpp, master.cpp, sensormodul.cpp]
2014-04-16 Added shell for PID variable command.
2014-04-16 fixat klasserna bluetooth och spi
    [master.cpp]
2014-04-16 Doesn't compile. Waiting for BT and SPI code.
    [master.cpp]
2014-04-16 fixat typ hela LCD
    [lcd.cpp, lcd.h, master.cpp]
2014-04-16 la till konstruktor i bluetooth
2014-04-16 lcd and sensormux pillade med
2014-04-17 fixat lite med displaykoden
    [lcd.cpp, lcd.h, master.cpp]
2014-04-17 fixat mer i row, update är ännu inte klar
    [lcd.cpp, lcd.h]
2014-04-17 Lines for LCD and Sensormodule send on SPI commented out, this is temporary and should be changed back when map is confirmed. Working on map send. Bluetooth changed wrong outDataArray. Maybe add PCou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
    [bluetooth.cpp, lcd.cpp, master.cpp, sensormodul.cpp]
2014-04-17 Noticed a small issue when slave sends to master the position variable is not reset, fixed in styr_m / slave. Needs to be implemented in sensor module.
    [Communication.cpp, Styr_m.cpp, slave.cpp, slave.h]
2014-04-18 working on sensor data. It is arriving on processor way too fast. Atleast 25 ms between transmissions are needed. To let processor do it's work.
    [bluetooth.cpp, sensormodul.cpp]
2014-04-18 Saving code before changing data length to 27 over SPI.
2014-04-18 Changed to 27 data protocol length. Will try it shortly, latest commit is original.
    [Communication.cpp, Communication.h, bluetooth.cpp, bluetooth.h, main.cpp, master.cpp, masterMap.cpp, masterMap.h]
2014-04-18 Reading Sensor data, incorrectly on longrange (negative numbers). Might have to do with average function.
2014-04-18 27 byte protocol working. Sensor data being sent to computer correctly. Data being sent, not that often. 350 average calculations must be wrong. or processor not running with external clock. Data arr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
    [master.cpp, sensormodul.cpp]
2014-04-19 Increased an int to a double so that it will represent correctly.
    [sensormodul.cpp]
2014-04-20 fixat LCD-koden kräver testning
    [lcd.cpp, lcd.h]
2014-04-22 Sensorvalues are now transmitted to computer. Might need recalibrating though.
2014-04-23 Fixed timestamp to be registered as double.
    [main.cpp]
2014-04-23 Ready() in Lcd seems to be working correctly now. Needs restructuring of drawing code to avoid the lockdowns that a while or delay brings with them. Proposition: Breeze past draw function in main and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
    [lcd.cpp, lcd.h, master.cpp]
2014-04-24 Wrote a PD parameter change send command. Removed the ugly up,down,left,right buttons in gui
2014-04-25 Tweaking with sample size and average function.
2014-04-25 Changed some trace prints and updated plotting
2014-04-28 Added last sensors sensorplot
2014-04-28 Robot now can receive sensor data.
2014-04-28 Some 30's that was missed.
    [order.cpp]
2014-04-28 Communication and Robot needs rewrite on handling sensordata.
2014-04-28 Gyrotest file. Seems decent.
2014-04-29 fixat gyro
2014-04-29 Styr compiles with ints for saving sensor values
2014-04-29 Failcheck when sensors out of range.
    [MapSection.cpp]
2014-04-29 Correction from last commit.
    [MapSection.cpp]
2014-04-29 Sensor values now enters.
2014-04-29 Added so that manual/auto button works more times than one.
2014-05-04 fixade gemensam reset, gyromode är satt till false.
    [master.cpp, sensormodul.cpp]
2014-05-04 lagt in så att gyrot kommunicerar korrektmedmaster
2014-05-05 Added support for writing out number of interrupts for RFID on display.
2014-05-05 New main loop for steering
2014-05-05 kommenterat sensormodul
2014-05-05 Merge branch 'master' of https://github.com/hansfilipelo/MapMaster2001
    Conflicts:
    Kod/sensormodul/sensormodul.atsuo
    Kod/sensormodul/sensormodul/sensormodul.cpp
2014-05-05 Commented out updateRobotPosition which is broken.
    [Styr_m.cpp]
2014-05-05 lagt till LED =)
2014-05-05 MapGUI small changes. Speed multiplier didn't update. And reference set to 10 cm
2014-05-05 pillade lite på toggle intervallet för LED
2014-05-05 Correction in delays and rotation speed.
    [MapSection.cpp, Styr_m.cpp]
2014-05-05 added special case for rightwall follow
2014-05-05 fixed one compile error. One function not declared yet.
    [MapSection.cpp]
2014-05-06 Sensorer i fördjupning
2014-05-06 Left sensor can close corridor
2014-05-06 Robot doesn't compensate when speed is zero.
    [MapSection.cpp]
2014-05-06 nollställer sensorvärden vid svängning
2014-05-06 Shorter delay after rotate since sensor values now is more correct after rotation.
    [Styr_m.cpp]
2014-05-06 Added save to file button
2014-05-06 added function to save sensor values
2014-05-06 Changed so that arrows now sends rotate 90 degrees and thereby manual steering works with mapping.
2014-05-07 extra command for escaping gyromod Pleas enter the commit message for your changes. Lines starting
2014-05-07 Changed reference since sensors are moved.
2014-05-07 made the autonom/manual button work with speed
2014-05-07 changed positions of sensorvalues on display
2014-05-07 Added a function that waits until new data has arrived from sensor
2014-05-08 fixat bug i master
    [master.cpp]
2014-05-08 fixed kp and kd parameters
    [MapSection.cpp, Styr_m.cpp]
2014-05-08 Commit for sensorplots
2014-05-09 la till mall för teknisk dokumentation samt kappa
2014-05-09 la till bilder till kappan
2014-05-12 Error in setControlParameters and removal of unnecessary compiler warnings.
    [MapSection.cpp, Styr_m.cpp]
2014-05-12 bytt till hjulräknare i sensormodulen (lite kalibrering i styr)
2014-05-12 skickar D när vi åkt 40 cm
2014-05-12 fixed segfault in isClosed
    [Map.cpp, MapSection.cpp, styrtest.cpp]
2014-05-12 Half added some smaller functions to clean up a switch
2014-05-13 Fixed debug flags around couts.
    [MapSection.cpp]
2014-05-13 isClosed works except for with one very unlikely case.
2014-05-13 vet i fan vad jag ska kalla den här commiten
2014-05-13 Waiting for sensordata before doing mapping stuff.
2014-05-13 'D' command in styr_m calling on command containing SPI code. Will not work. Master delaying when sending map, might lose data. Shell for confirmation from PC exists, but is somehow very slow ~100 ms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
    [Communication.cpp, MapSection.cpp, MapSection.h, bluetooth.cpp, bluetooth.h, master.cpp]
2014-05-14 Commented out code. Map send not working properly. Why unknown.
    [Communication.cpp, Communication.h, MapSection.cpp, Styr_m.cpp, master.cpp]
2014-05-14 Delay fixing. FCPU properly declared. Waitfornewdata using delays.
    [Abstraction.cpp, Abstraction.h, Communication.cpp, Map.cpp, Map.h, MapSection.cpp, MapSection.h, Styr_m.cpp]
2014-05-14 We are now back on track, correctly merged file
    [MapSection.cpp, MapSection.h, Styr_m.cpp]
2014-05-14 Change in master to have timer for transmission of map instead of delays.
2014-05-14 Activated sendMap on rotate in steer module.
2014-05-14 Removed compile error with g++ on x86.
    [MapSection.cpp]
2014-05-14 Changed logic error in isClosed() and started making isReachable()
    [MapSection.cpp, MapSection.h, Styr_m.cpp]
2014-05-15 Bugfix in isClosed(). Switched limits on x and y
    [Map.cpp, MapSection.cpp, styrtest.cpp]
2014-05-15 sensormodul i kappan
2014-05-15 Revert to 9 may commit:
    With message "Changed so trim value works procentual instead"" and with SHA 6b79be84cb0a24e80cbe0deefb79809a7b2809e4
    [Abstraction.cpp, Abstraction.h, Communication.cpp, Communication.h, Map.cpp, Map.h, MapSection.cpp, MapSection.h]
2014-05-15 Stable bus implementation. Scrapping all sensor data after atomic bus transmissions seems to make it stable. Two test at 254 wheel turns working.
2014-05-15 Updaterat kopplingsschema till sensormodul
    [sensormodul.sch]
2014-05-15 Issues with Bus (wheelsensor) again, maybe fixed? Restructured code in sensor, maybe optimized away? Code seems sensitive towards interrupts from BT.
    [MapSection.cpp, master.cpp, sensormodul.cpp, spi.cpp]
2014-05-15 Bus seems to be stable. Robot currently halts after a section traveled. Is robot in wrong position from start? (far right in GUI). Robot closes incorrectly on short side. Maybe on long side aswell.
    [MapSection.cpp]
2014-05-16 GUI map rotation and resetBT command
    [Styr_m.cpp, order.cpp, order.h, serialport.cpp, spi.cpp]
2014-05-16 skrivit om sensormodulen i TD
2014-05-16 Added endif which I just deleted by mistake
    [Styr_m.cpp]
2014-05-16 Steermodule not resetting anymore! The issue is located with the 'newoperator' implementation. Currently getColAsChar is reimplemented temporarily for testing purposes. Seems to be working. WheelSens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
    [Communication.cpp, Map.cpp, Map.h, MapSection.cpp, MapSection.h, Styr_m.cpp, master.cpp]
2014-05-17 Non-Compiled. WheelSensor now sends three command bursts to master.
2014-05-17 Changed small issue in master, would not compile. Changed structure in sensor Sensor will now check wheelmode flag before delaying before next transmission.
    [master.cpp, sensormodul.cpp]
2014-05-17 Redundancy on sending w from steer.
2014-05-17 Small issue with 'x' btReset. Did not return from function after "resetting"
    [bluetooth.cpp]
2014-05-17 Segmentsturned is now reset after rotation to avoid movement in map when rotating.
    [sensormodul.cpp]
2014-05-17 Redundancy for gyro request. Not tested.
2014-05-18 Robot::setLeftClosed() changed so it doesn't overwrite closed areas. Not tested. Made Styr compilable with node since it wasn't and didn't compile. Don't know if it compiles with Atmel.
    [Communication.cpp, Map.cpp, MapSection.cpp]
2014-05-19 rfid-avstånd för aktiv tagg i sensorfördjupning
2014-05-19 Fixed datatransmisison speed to improve PD-regulation and right wall following. Seems to work, still erratic behaviour on manual/auto switch
    [Communication.cpp, MapSection.cpp, MapSection.h, Styr_m.cpp, master.cpp, sensormodul.cpp]
2014-05-19 PWM in kappa.tex
2014-05-19 la till i LCD på tekdok
2014-05-19 Kappa.tex, sensormodul splittrad i underkategorier
2014-05-19 updatePosition on rotate fixed.
    [MapSection.cpp, sensormodul.cpp]
2014-05-19 Added accessorfunctions for isVisited and fixed so visited points in map can't be closed
    [Map.cpp, Map.h, MapSection.cpp, MapSection.h]
2014-05-19 uppdaterat sensormodulkoppling.png
2014-05-20 Project file with include to stl
2014-05-20 RFID på W-kommando i sensormodulen
2014-05-20 Sensorfördjupningen med feedback från handledare
2014-05-20 isClosed testing. Not working.
    [Map.cpp, MapSection.cpp, styrtest.cpp]
2014-05-20 Added \ in Sensorer, moved updated Sensorer.tex to correct level (not New Sensor) so pics can compile. Updated small things in kappa.tex Added PDF's to end of Kappa.tex, not added PDF's, they are nee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
2014-05-21 Davids commit på dokumentation.
    [sensormodul.sch]
2014-05-21 Folder namechange.
    [Kom_modul_uptodate.sch, sensormodul.sch]
2014-05-21 fixade path-utritning i guit
    [serialport.cpp]
2014-05-21 fixat kod som david skrev men som inte kompilerade
    [Communication.cpp, Map.h, MapSection.cpp, MapSection.h, Styr_m.cpp]
2014-05-21 updaterat sensorfördjupning
2014-05-21 Error in if statementw
    [MapSection.cpp]
2014-05-21 Sensorer kompilerar.
2014-05-22 Version that stops looking for U after 3 attmepts, closing it. If it gets stuck on island (i.e.) after a goAcross() it does another goAcross when it comes back to same position. GoHome implemented. b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
    [MapSection.cpp, MapSection.h, Styr_m.cpp, main.cpp]
2014-05-22 Removed compile errors to Sensorer.tex.
2014-05-22 Sensor now has same pagestyle.
2014-05-22 exploringIsland ow sets correctly
    [MapSection.cpp, Styr_m.cpp]
2014-05-22 This code is the closest thing we got RFID might not work. Busproblems once in 200 gyros/wheels
    [Map.cpp, Map.h, MapSection.cpp, Styr_m.cpp]
2014-05-23 Increased post transmission delays in sensormodule. Hopefully solves lost command
2014-05-23 pin-avbrott för gyro och wheelsensor
2014-05-23 Wheel and gyro is sent over interrupts
2014-05-23 interrupts från styr till sensor
2014-05-23 Interrupts in both directions now
2014-05-23 updaterat kopplingsschema och komponenttext på sensor
2014-05-23 la till felsökning i manualen
2014-05-25 Lite sensor. Lite omstök och inledning till förbättringar.
2014-05-25 ändrat till nutid under sensormodul
2014-05-25 ny bild p lpfilter och smrre korrigeringar, dock ej klar med bild pa koppling av sensorer
2014-05-26 Corrected in sensorpart of tekdok.tex
2014-05-26 infogat bild och lista om hur sensorer ska kopplas
2014-05-26 Omformulering. Nytt appendix för sensorkoppling.
2014-06-03 Moved end of document in Sensorer.tex Added link to github in kappa (inledning).
2014-06-03 la till tid.png
